pwbsu/Raspberry-Pi-Laparoscope/Documents/Prelimanry Report/chaps-append/chap-drawing.tex

\chapter{Drawings}
\label{sec:Drawings}

\begin{figure}[H]
    \centering
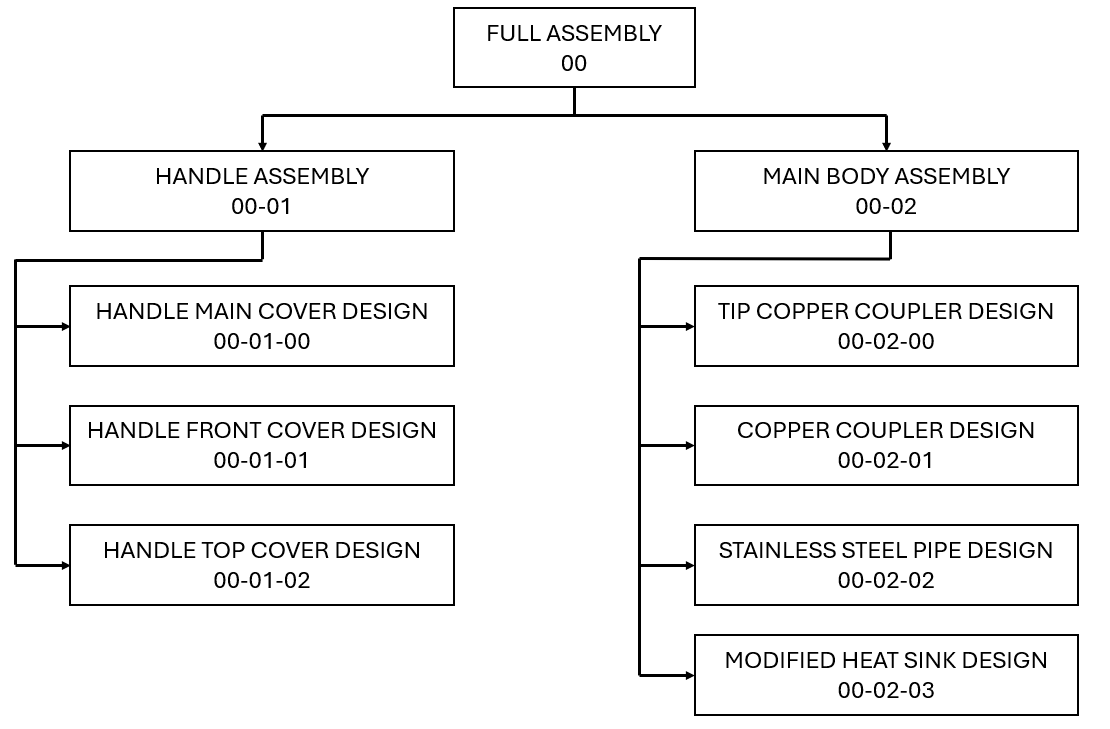
[picture p13: Documents/Prelimanry Report/figs/Drawing Tree.png]
    
    
    \label{fig:ADrawing Tree}
\end{figure}

\begin{landscape}
    \begin{figure}[H]
        \centering
        
        
        \label{fig:App Full Assembly}
    \end{figure}

    \begin{figure}[H]
        \centering
        
        
        \label{fig:App Main Assembly}
    \end{figure}
\end{landscape}
