pwbsu/Raspberry-Pi-Laparoscope/Documents/Prelimanry Report/chaps-main/chap-heat.tex

\chapter{Heat Transfer Evaluation}
\label{sec:Heat}
