pwbsu/Raspberry-Pi-Laparoscope/Documents/Progress Report/chaps-main/chap-conclusion.tex

\chapter{Conclusions}
\label{sec:Conclusion}

\section{Conclusion}

Laparoscopy is a rapidly expanding industry in the medical field. Its an innovative approach to minimize the harm surgeons inflict on the patients. However, it is a more complex procedure to perform, thus requiring more training. Consequently, there is a desire for medical robots to assist surgeons during laparoscopic surgery.

\vspace{0.5cm}
\noindent
Therefore, there is a need for a low-cost laparoscope for training purposes. Consequently, it can be used for prototype testing of new medical robots. This low-cost laparoscope is to be tested to determine its functionality. Therefore, a testing station is required to be developed to determine the laparoscope's capabilities.

\vspace{0.5cm}
\noindent
For this reason, this project aims to develop a low-cost laparoscope in addition to a testing station.
