pwbsu/Raspberry-Pi-Laparoscope/Documents/Design specifications for laparoscope/Diagrams.pptx

Environment

External Environmental Conditions

Legend
Material
Information
Energy

DIP_03, DIP_06

Wider System of Interest

Laparoscope standards

DIP_01, DIP_05, DIP_07

DIP_08

Narrower System of Interest

End-user

Stellenbosch University

Power Storage

DIP_04

DIP__02

## Slide 2

Digital storage unit

Digital storage unit

Legend
Material
Information
Energy

Signal

6.0

Store system data

User input

1.0

User Interface

Signal

2.0

System processor

Signal

AND

Signal

5.0

Display real-time images

Real-time display

Signal

4.0

Signal

Operate camera module

Electrical energy

3.0

Electrical energy

AND

Electrical energy

Power supply

Electrical energy

## Slide 3

4.0 Operate Camera Module

Legend
Material
Information
Energy

4.1

Signal

Configure camera properties

4.3

Signal

AND

Signal

Capture digital image

Signal

Signal

4.2

Configure light intensity

Electrical energy

Electrical energy

## Slide 4

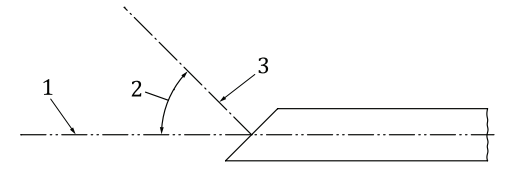
[picture p14: figure]

Camera Axis

Axial Rod Axis

Viewing Angle
