pwbsu/Raspberry-Pi-Laparoscope/Documents/Design specifications for laparoscope/Problem Definition.docx

Problem Definition:

Laparoscopic surgery is a minimally invasive surgery technique, that allows patients to recover faster and experience reduced amounts of post operations pain. However, the main drawback of this procedure is the complexity to perform these operations as well as the steep learning curve to learn the techniques.

Laparoscopic surgical robots are also a new development in the medical industry. There is current product available for commercial surgical use, however, there are new version being developed. Consequently, during testing of the prototypes of new developed robotic system, it isn’t required to use expensive medical grade equipment.

Additionally, Stellenbosch university would like to have a demonstration station during future career days, where participants can use a laparoscope to perform laparoscopic surgery on phantom bodies, to visualize the experience.

For the reasons above, a low-cost laparoscope needs to be developed. The developed product should look and functions as a standard laparoscope. However, since it will not be used on alive patients, the developed product should not meet any medical standards, considering the quality and materials used of the system. The developed should be able to fit inside a Ø 10 mm hole, should exhibit the same functional requirements a standard medically approved laparoscope.
