pwbsu/Raspberry-Pi-Laparoscope/Documents/Detail Design/Diagrams.pptx

Camera and LEDs

Laparoscope encasing

PCB

Heat Pipe
