pwbsu/Raspberry-Pi-Laparoscope/Documents/Safety Reports/Diagrams.pptx

Computer

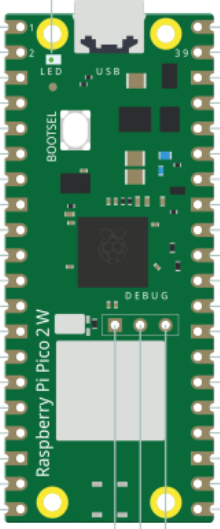
[picture p20: figure]

DS18B20

DS18B20

DS18B20

4,7 kΩ

Legend
Ground
DQ
USB Micro-B

## Slide 2

Computer

5 V

DC Power Supply

Endoscope camera module

DS18B20

100 Ω

4,7 kΩ

100 Ω

100 Ω

100 Ω

Legend
Ground
DQ
USB
