pwbsu/Raspberry-Pi-Laparoscope/Documents/Detail Design/Drawings/Drawing Tree.pptx

FULL ASSEMBLY
00

HANDLE ASSEMBLY
00-01

MAIN BODY ASSEMBLY
00-02

TIP COPPER COUPLER DESIGN
00-02-00

HANDLE MAIN COVER DESIGN
00-01-00

HANDLE FRONT COVER DESIGN
00-01-01

COPPER COUPLER DESIGN
00-02-01

HANDLE TOP COVER DESIGN
00-01-02

STAINLESS STEEL PIPE DESIGN
00-02-02

MODIFIED HEAT SINK DESIGN
00-02-03
