pwbsu/Raspberry-Pi-Laparoscope/Documents/Detail Design/Drawings/Drawing_Pack.docx

# Laparoscope Drawing Pack

| Student | Supervisor
Initials and Surname | PW Breytenbach | Prof K. Schreve
Email Address | 26122146@sun.ac.za | kschreve@sun.ac.za
Contact Number | 078 780 9388
Signature

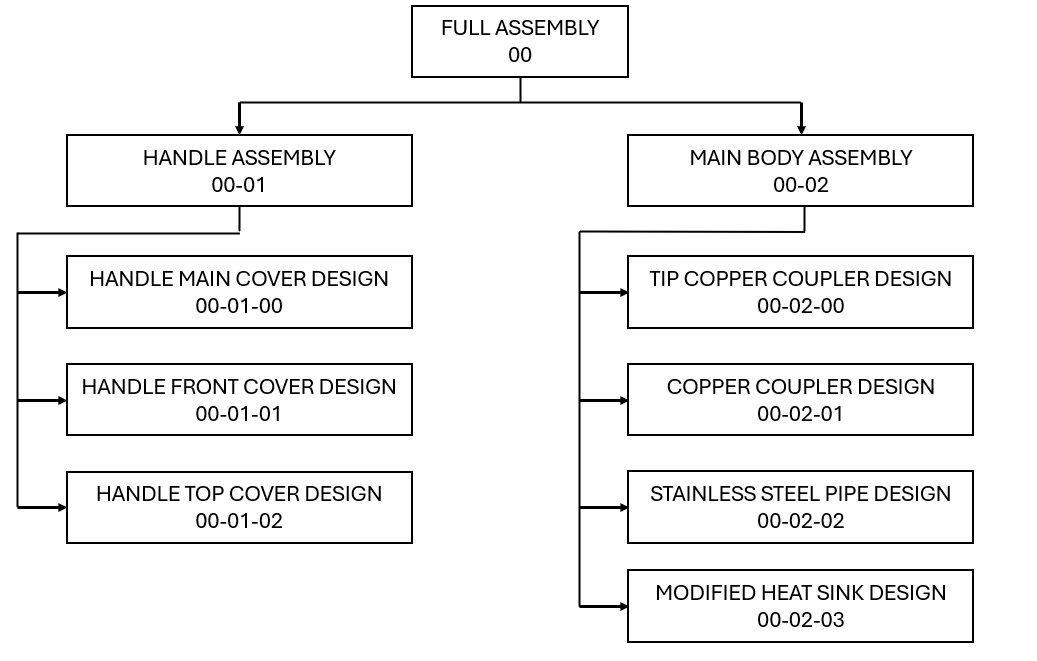
[picture p21: figure]

Notes for the assembly:

Parts that interface with each other that are not connected by a bolt and nut connection are secured by epoxy. Thus, all parts that interface with the heat pipes and stainless steel pipe will be secured by epoxy. The entire assembly of the design will be performed by the student, including the application of epoxy.

Order of assembling the handle of the laparoscope:

1. Assemble the entire main body assembly, except for the heat sinks.
2. Insert and secure the heat pipe and stainless steel pipe into the “Handle Front Cover”.
3. Connect the heat pipe to the heat sinks.
4. Connect the “Handle Front Cover” to the “Handle Main Cover”.
5. Connect the heat sinks to the “Handle Main Cover”.
6. Connect the “Handle Top Covers” to the “Handle Main Cover”.

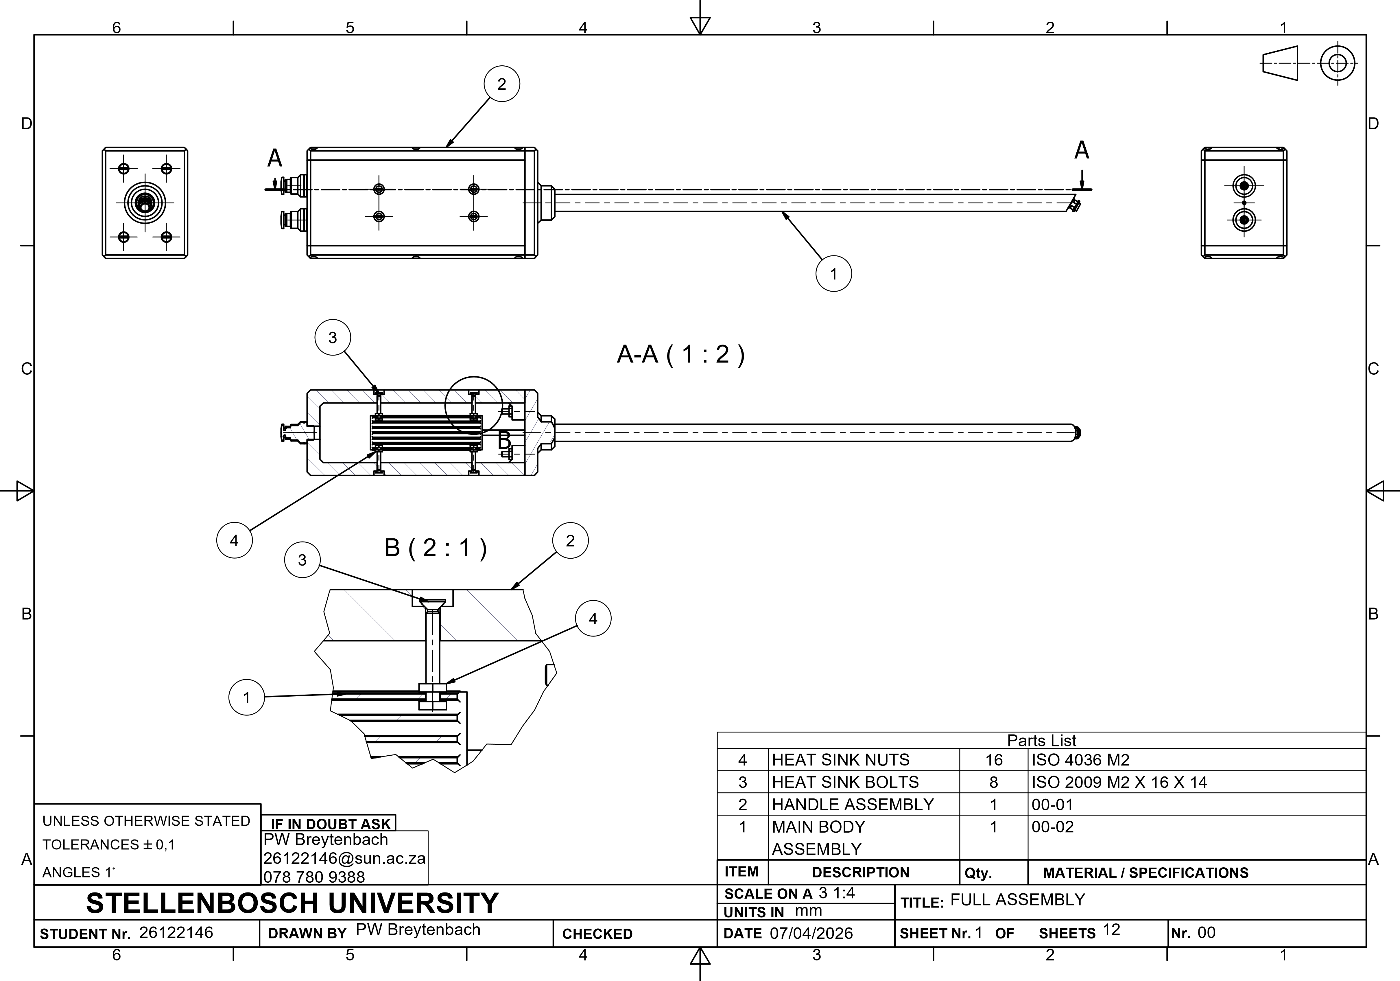
[picture p22: figure]
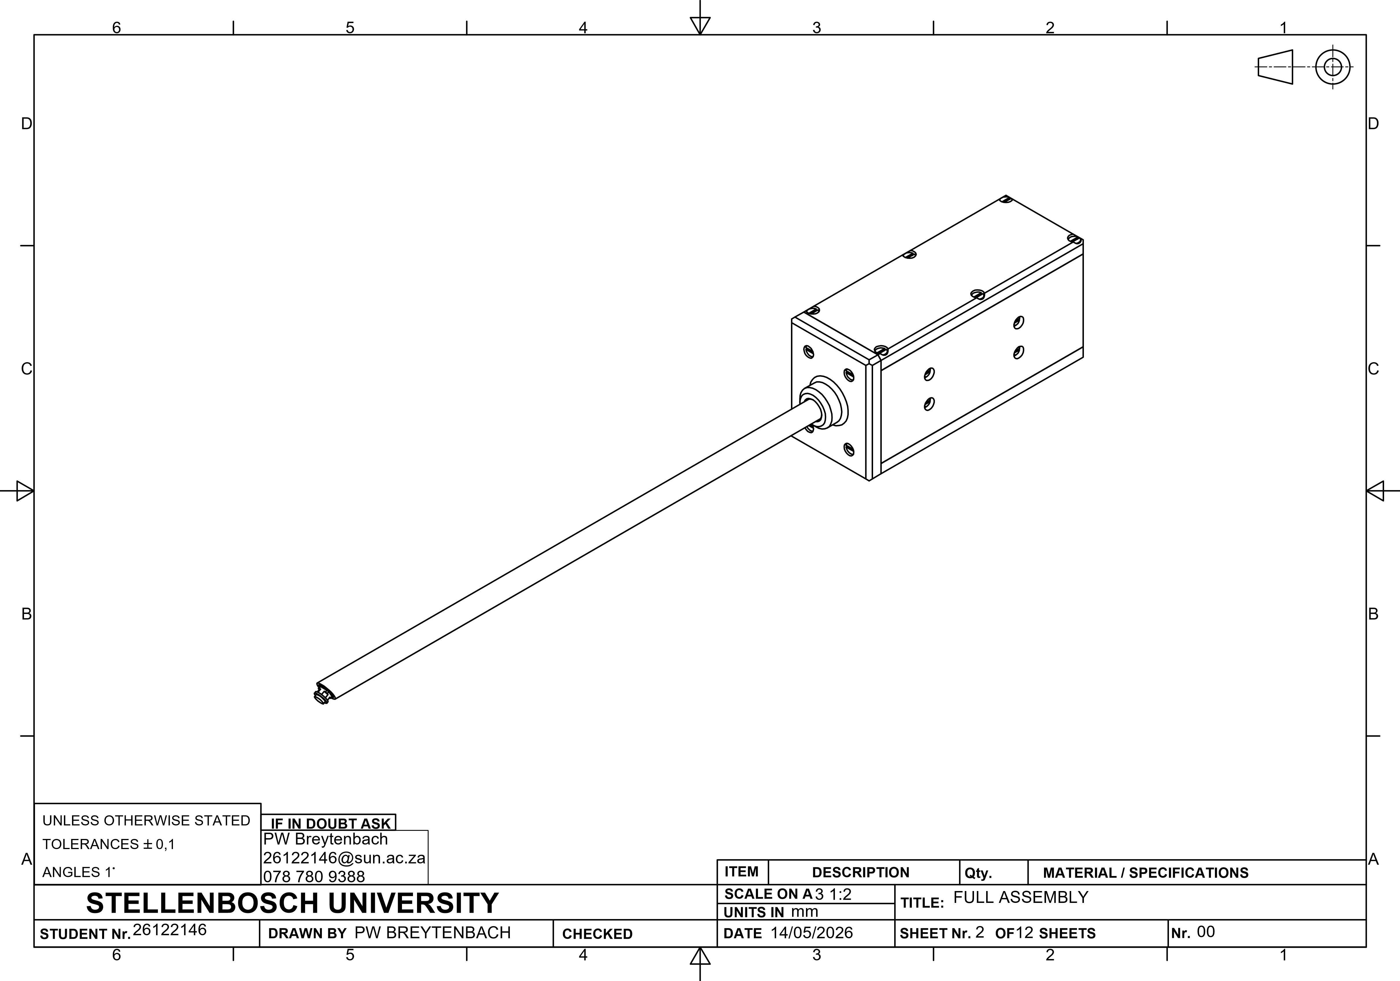
[picture p23: figure]
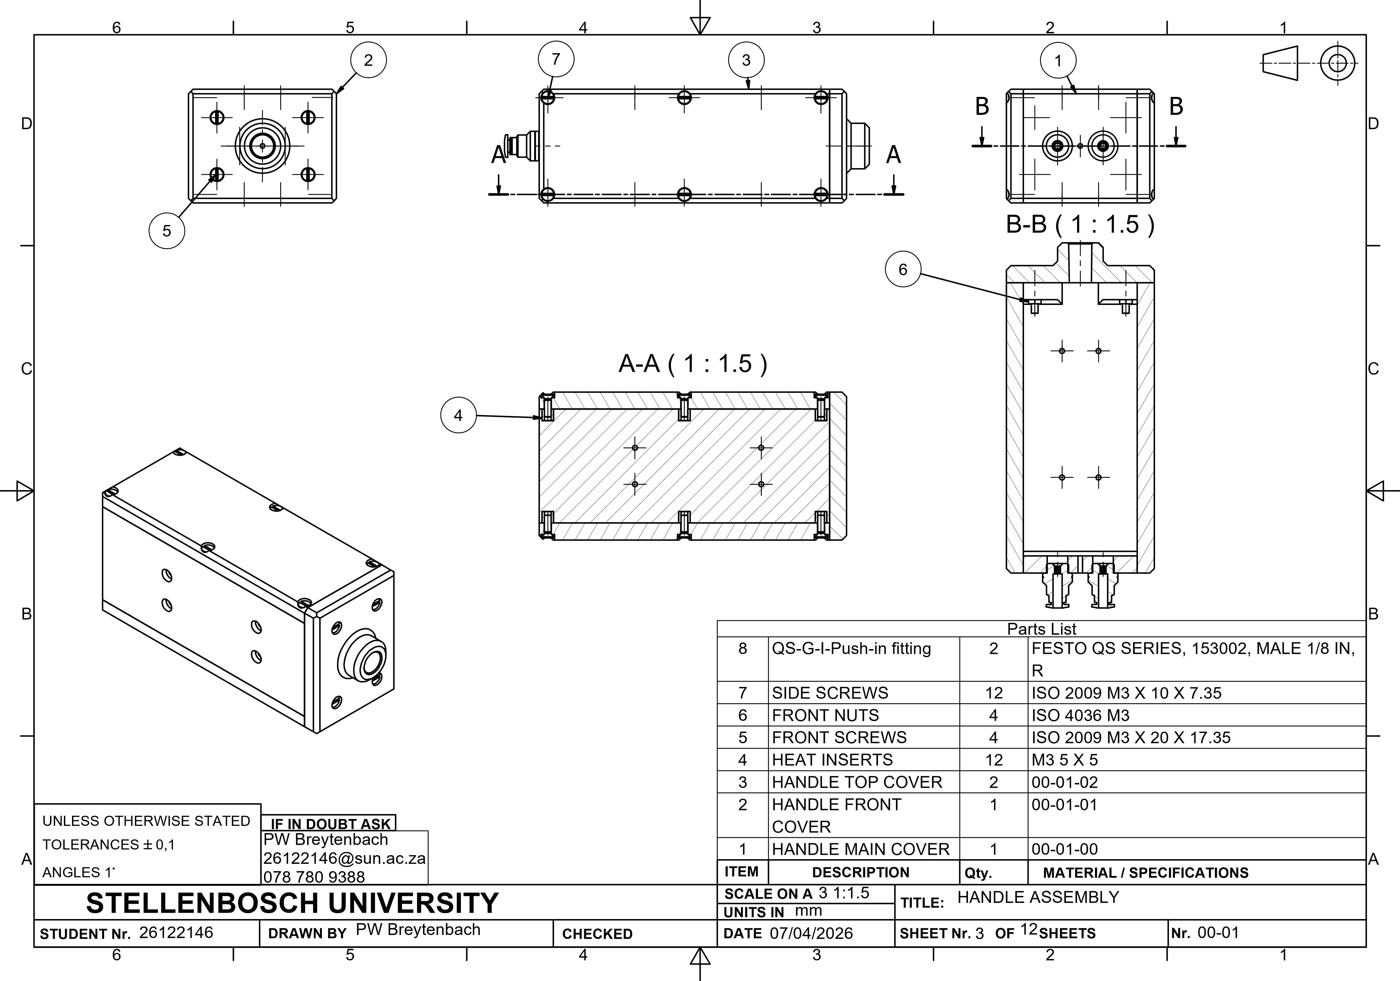
[picture p24: figure]
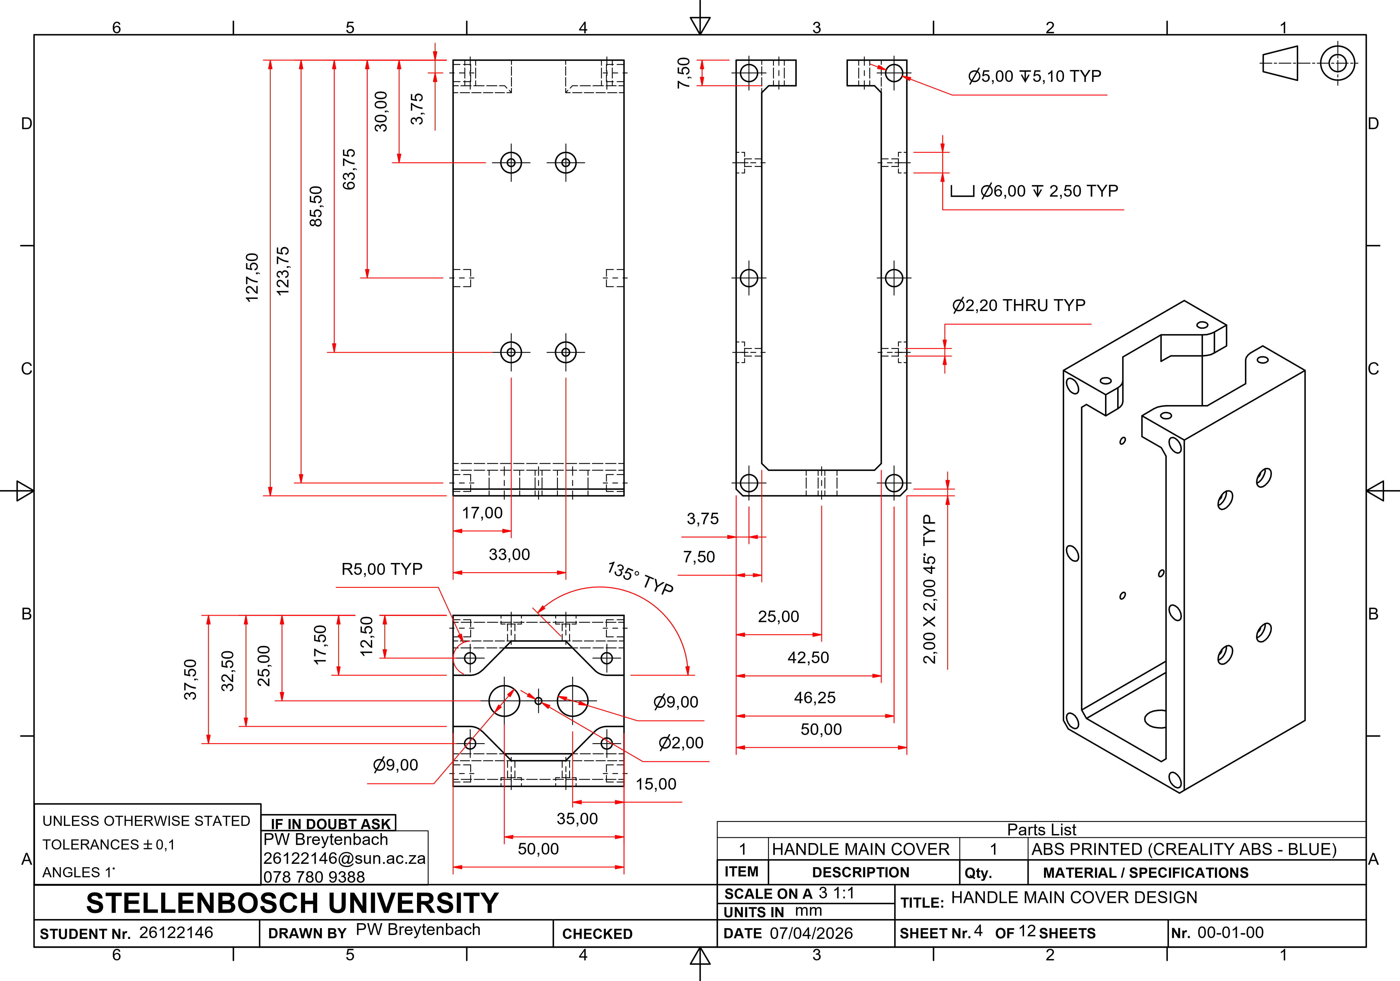
[picture p25: figure]
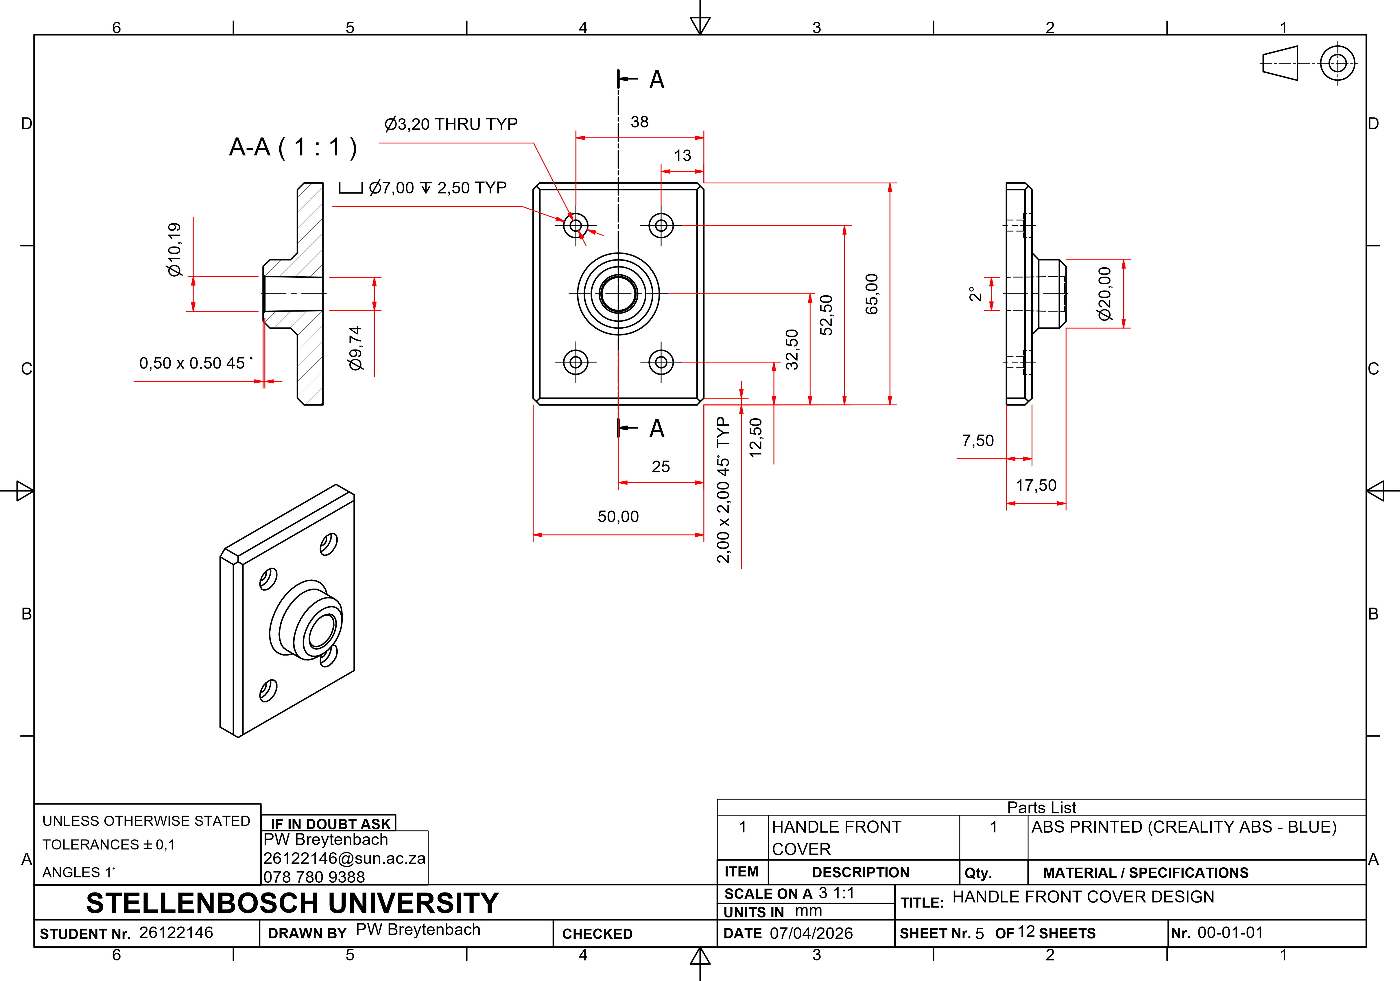
[picture p26: figure]
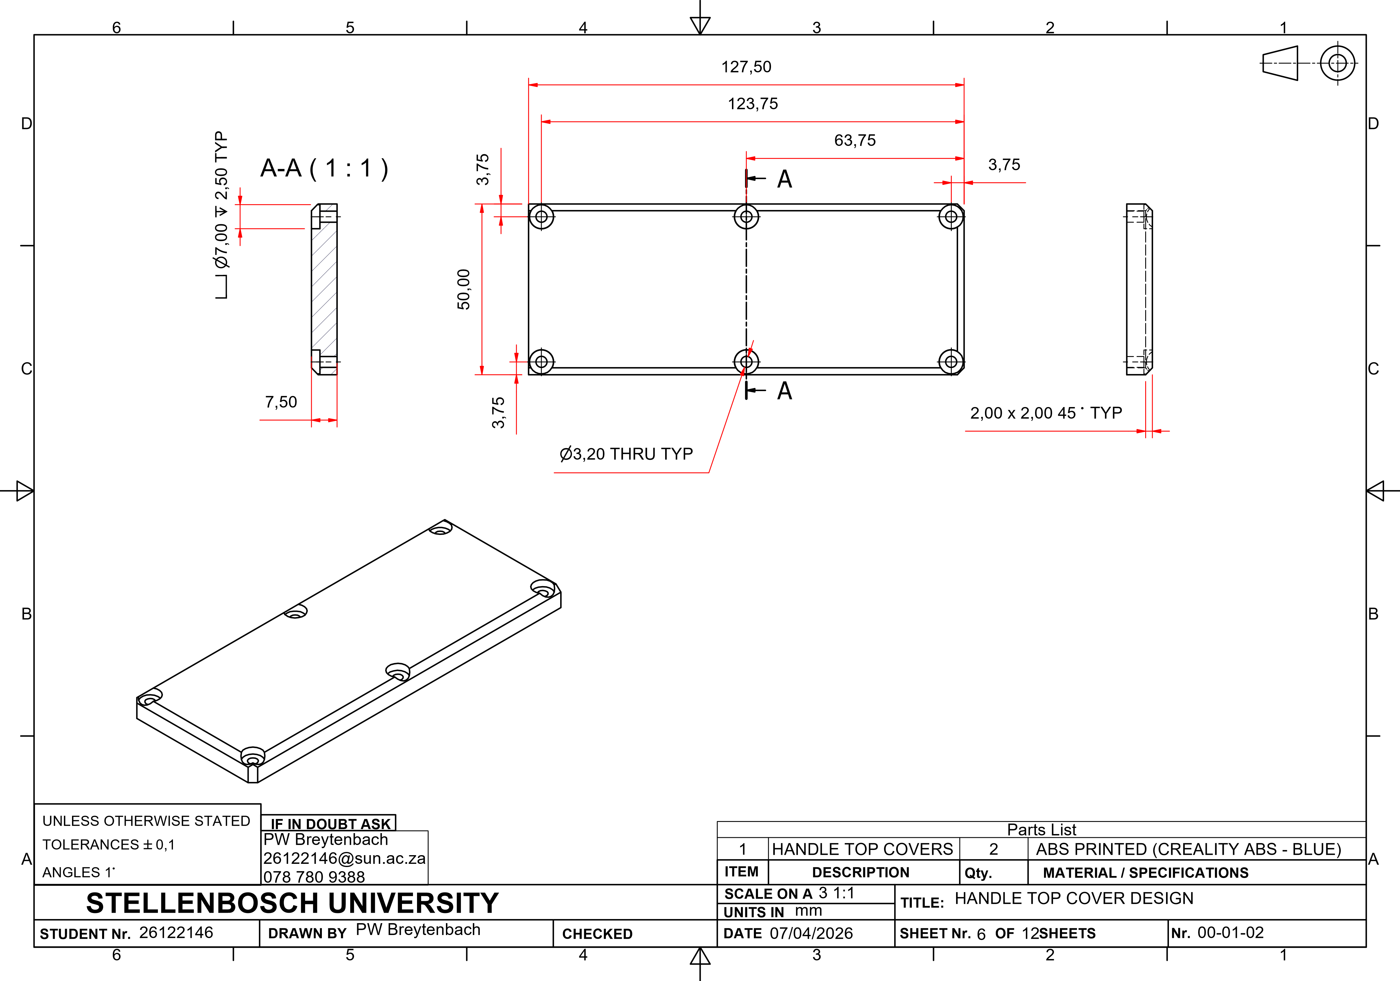
[picture p27: figure]
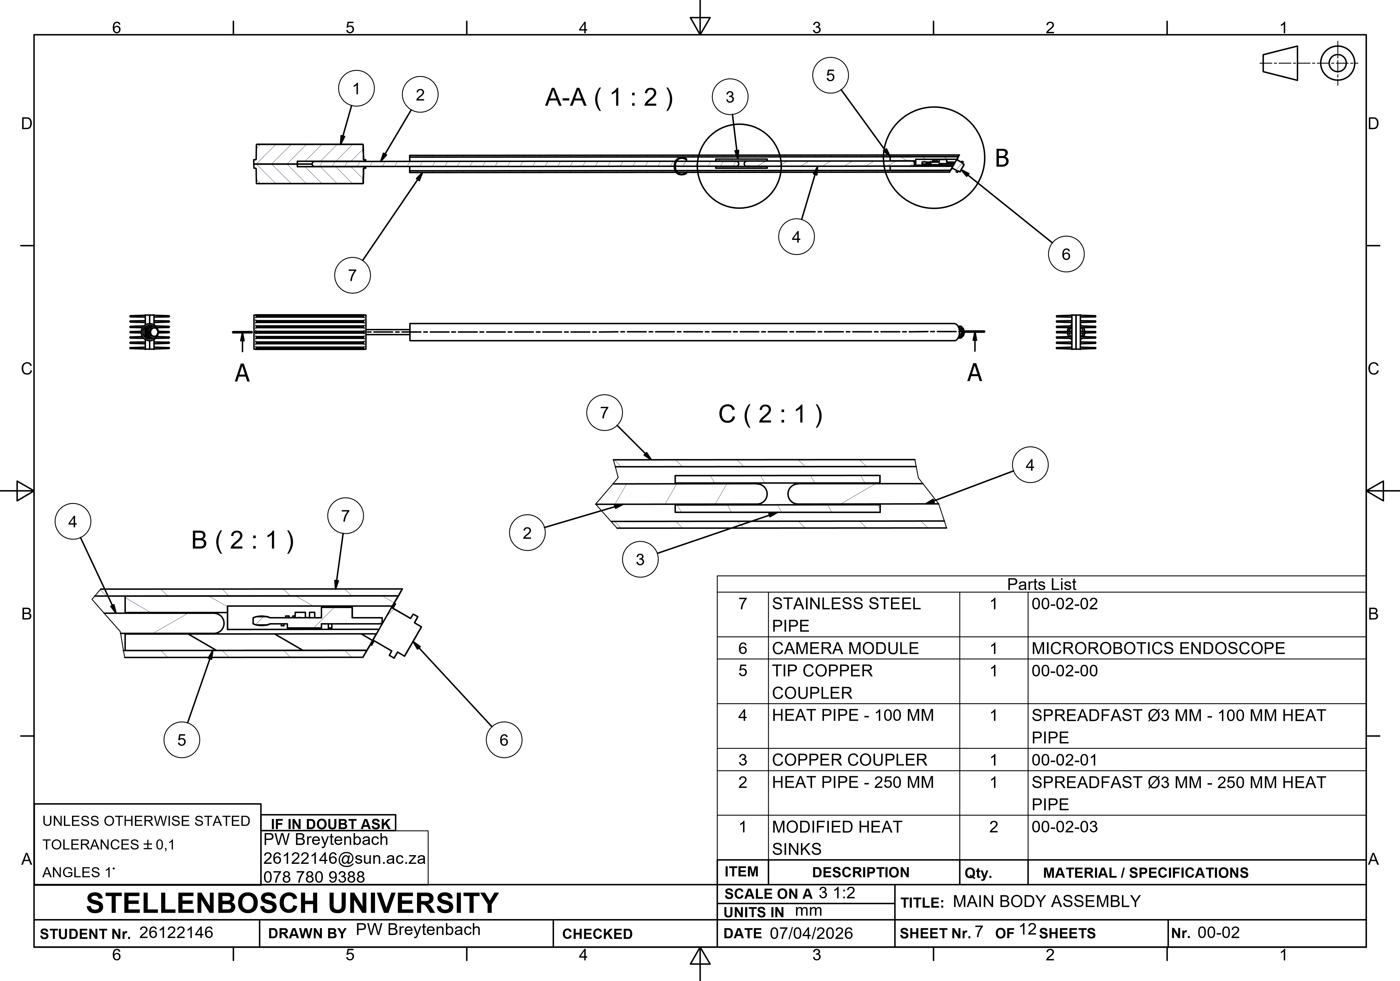
[picture p28: figure]
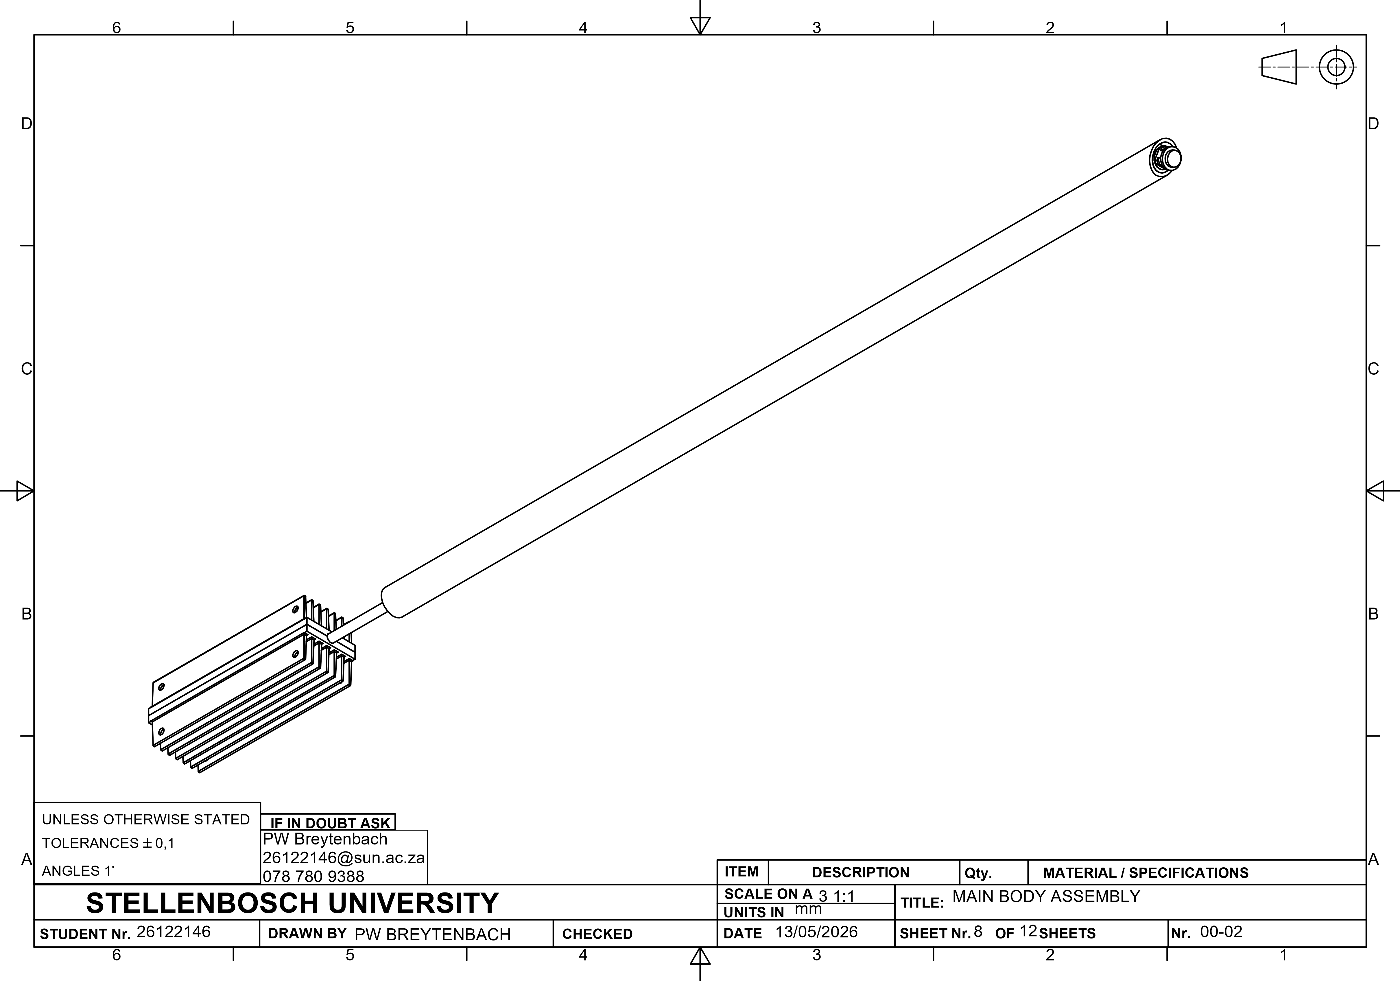
[picture p29: figure]
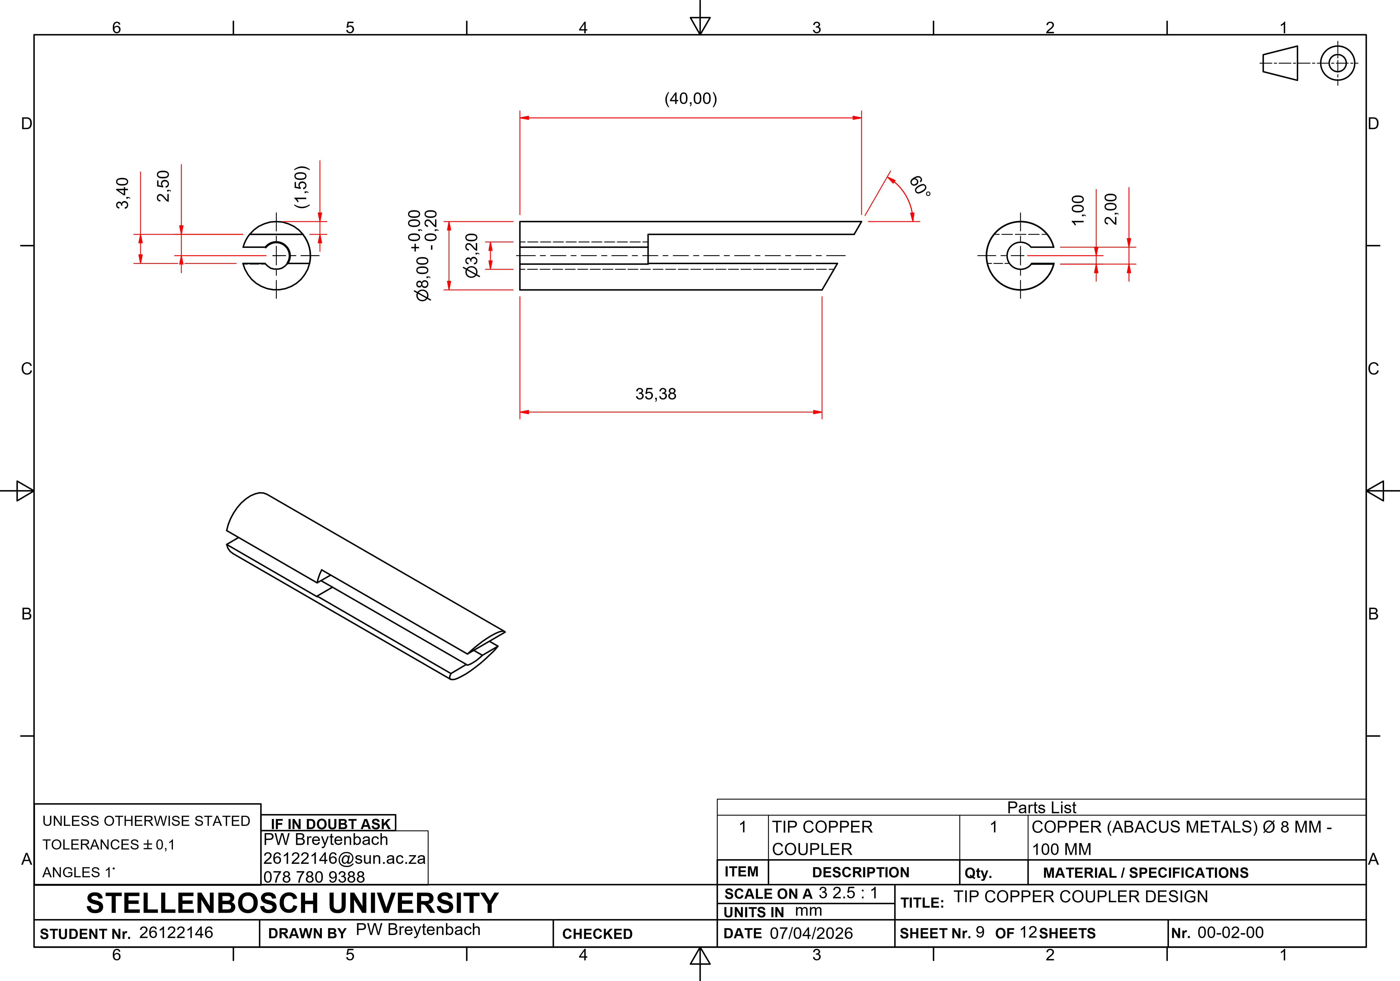
[picture p30: figure]
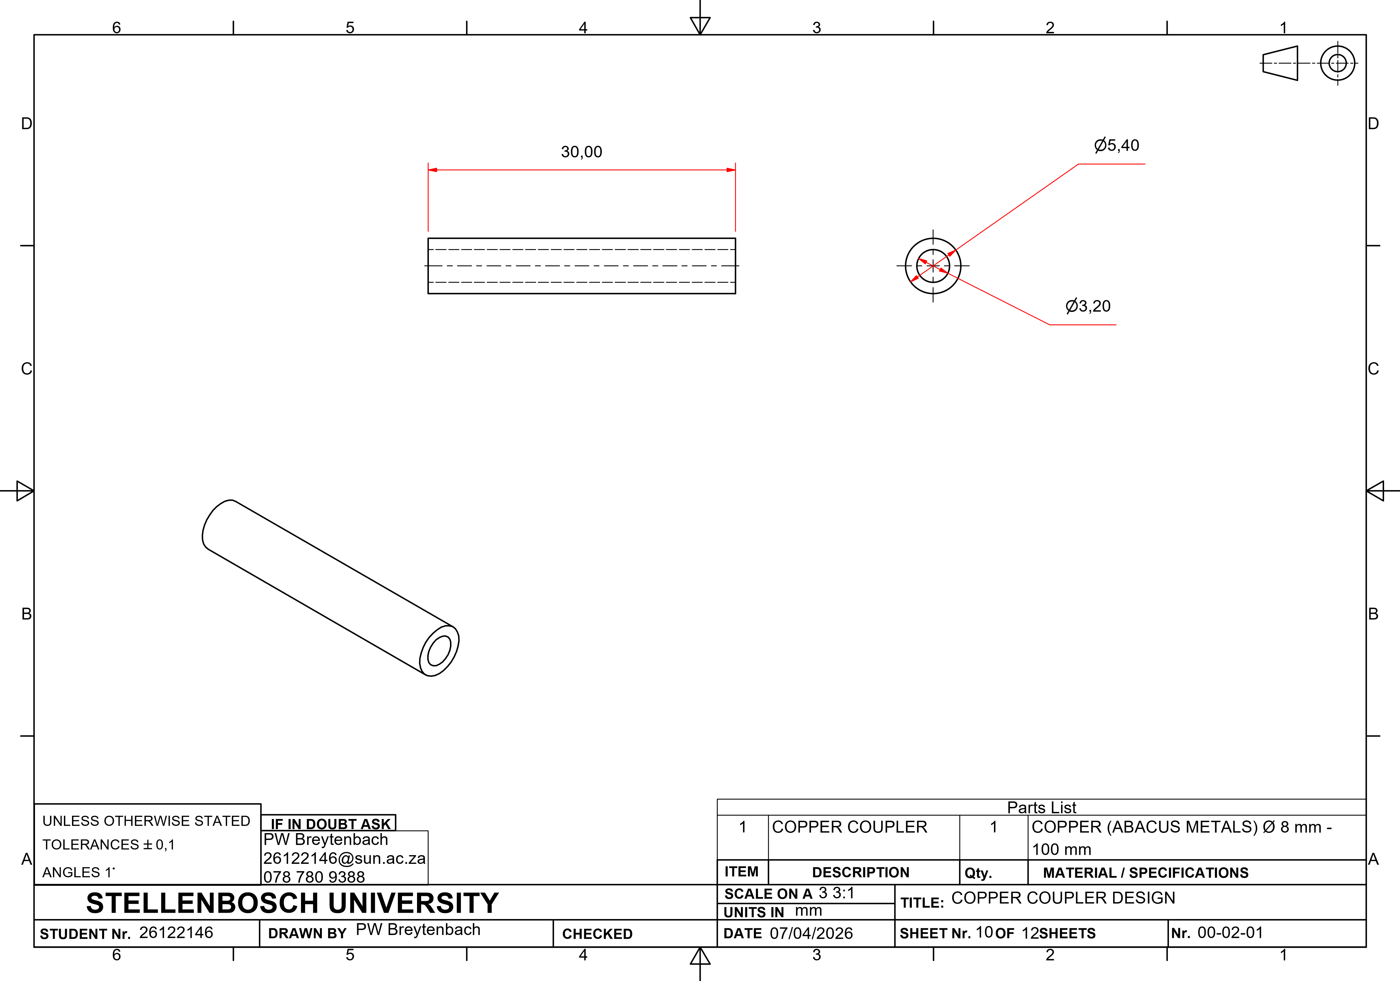
[picture p31: figure]
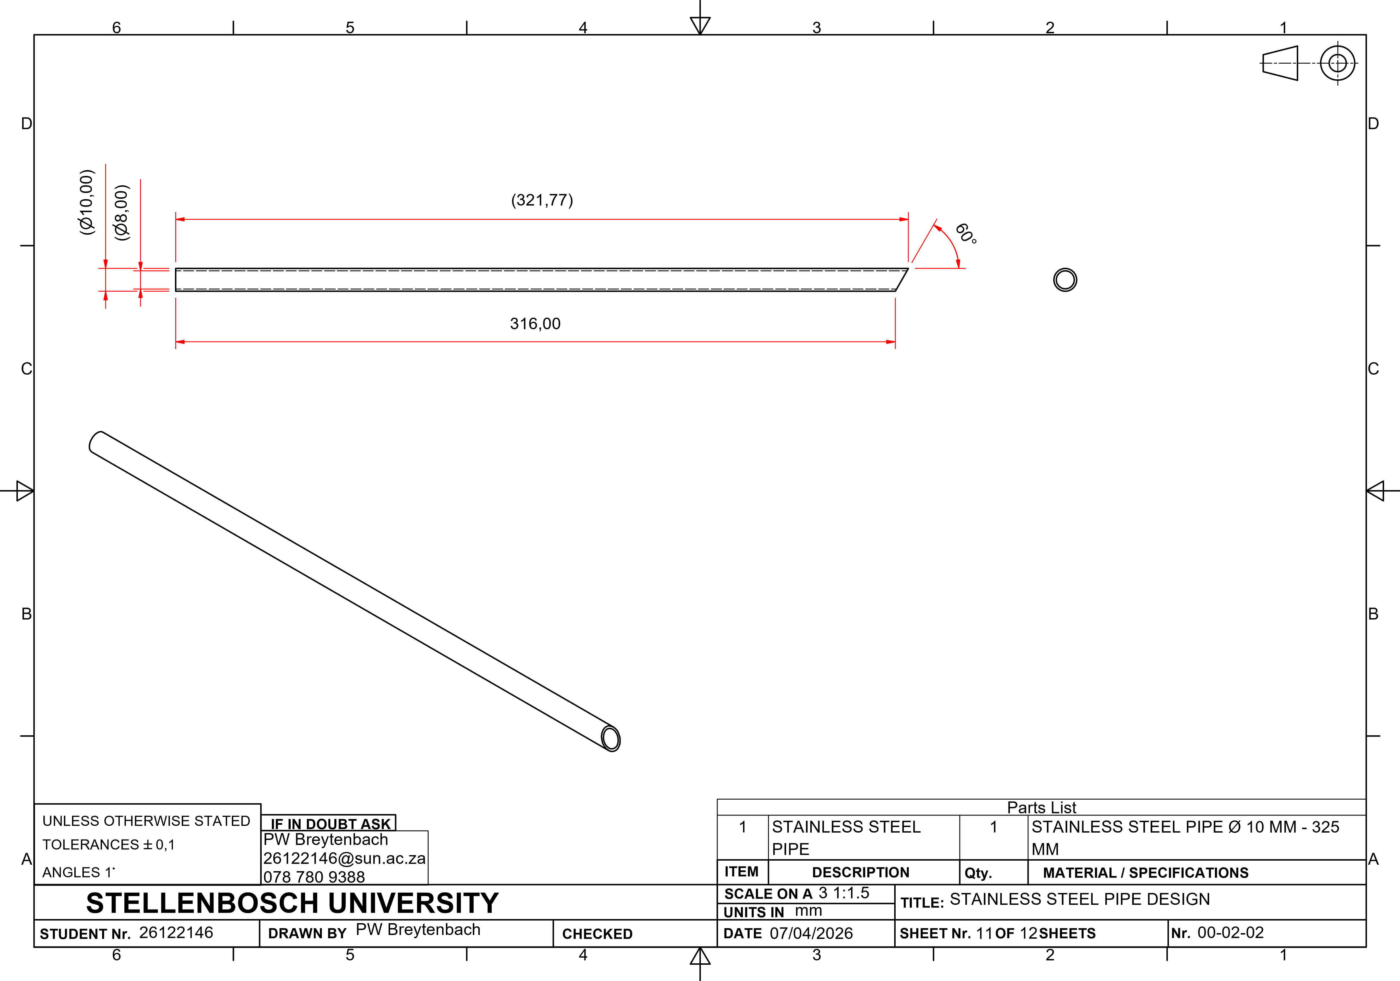
[picture p32: figure]
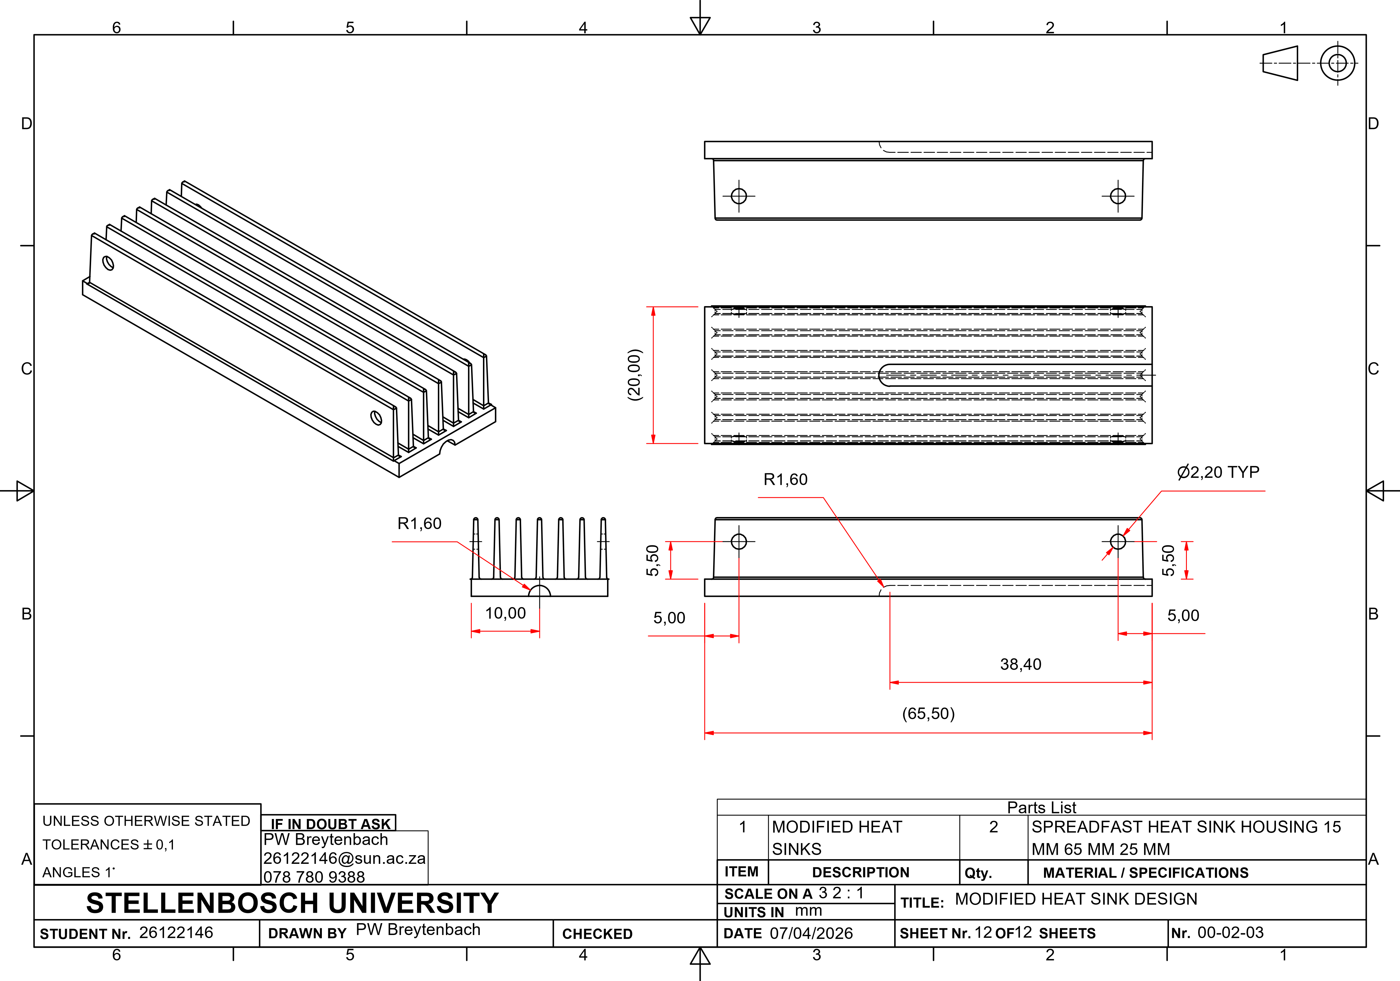
[picture p33: figure]
