pwbsu/Raspberry-Pi-Laparoscope/Admin/Meetings/17 Feb 2026/Background, Aim and objectives.docx

# Background:

The Hippocratic Oath is a fundamental principle that guides decisions and advancements in the medical profession. It motivates doctors and physicians to make ethical decisions to minimize patient harm. It also drives physicians to continuously improve practices to reduce surgical risks and complications. This principle has driven the discovery of minimally invasive surgery (MIS). (Alkatout, et al., 2021)

Minimally invasive surgery has become the standard practice across surgical fields and is a rapidly growing division in the medical industry. One branch of this field is laparoscopy, which is used to perform advanced and complex surgical procedures.

Laparoscopy is surgical approach where small incisions are made to allow insertion of specialized equipment into the patient’s body. The primary instrument is the laparoscope, which is typically paired with other thin rod equipment based on the operations demands. (Subido, Pacis, & Bugtai, 2018) Compared to traditional open surgery, laparoscopy offers advantages including faster recovery rates and reduced morbidity and patient discomfort, though it requires a steeper learning curve. These benefits translate to cost savings through shorter hospital stays and reduced analgesic requirements (Buia, Stockhausen, & Hanisch, 2015)

The laparoscope is a fundamental instrument to laparoscopic surgery. It consists of a thin rod with an attached camera that is inserted into the patient’s body. The captured footage is displayed in real-time to the surgical staff on a monitor. Based on the visible footage, the surgical staff make diagnosis, perform procedures, and coordinate instrument positioning based on the visual feedback.

Recent advancements in laparoscopy focus on improving the laparoscope’s visual capabilities through several approaches. These approaches include increasing the camera’s field of view, implementing three-dimensional (3D) visualization, and incorporating artificial intelligence (AI) or machine vision technologies to captured footage. Additional advancement made to modern laparoscopes is the utilization of robotic manipulators, with 3 or more degrees of freedom (DOF) to assist the doctor during operations. (Subido, Pacis, & Bugtai, 2018)

One of the main challenges of laparoscopic surgery is that it is a technically complex surgery to perform. Thus, more training is required by inexperienced surgeons. However, laparoscopes are expensive equipment which makes them inaccessible to individual practitioners or small hospitals to purchase. (Xiao, et al., 2014)

Therefore, there is a need of a low-cost laparoscope.

# Aim and Objectives

The aim of this project is to design, build, and test a low-cost laparoscope.

This project’s main objectives are to:

- Design, build and program a functional laparoscope by incorporating various Raspberry Pi components.
- Design a performance test to assess the laparoscope functionality and image quality abilities.
- Evaluate the developed laparoscope against established industry standards.

# Use of AI Tools

Anthropic is the main Artificial Intelligence (AI) company that will be used for this project, specifically its Claude Sonnet 4.5 model. This AI model assisted with research papers identification, sentence construction, grammar checks and code debugging. All AI-generated material will be reviewed and verified by the student to ensure the integrity and originality of the provided work.
