pwbsu/Raspberry-Pi-Laparoscope/Documents/Detail Design/Micro Robotics Camera Module/Images of Camera.docx

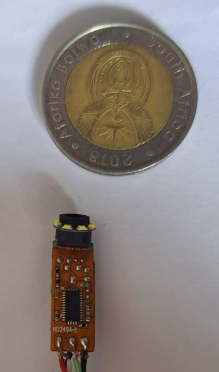
[picture p66: figure]
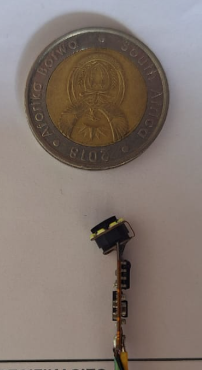
[picture p67: figure]
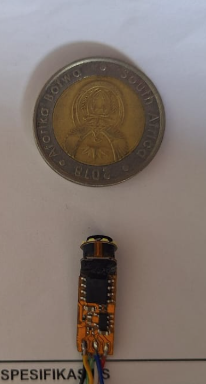
[picture p68: figure]
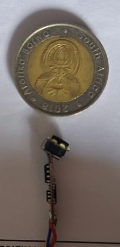
[picture p69: figure]
