pwbsu/Raspberry-Pi-Laparoscope/Documents/Prelimanry Report/gantt_chart.pdf

Skripsie | 01 Mar 2026
Stellenbosch University,
Engineering Facaulty,

## Mechanical and Mechatronic Department

| http://

Project manager
Project dates | 03 Mar 2026 - 16 Jun 2026
Completion | 0%
Tasks | 94
Resources | 0

This gannt chart will show the schedule for the skripise topic: Raspberry Pi Laparoscope.

Student number: 26122146
Student initails and surname: PW Breytenbach

Name | Be gi n
| da te

End date

Literature Review | 20 26/ 03/
| 03

2026/03/05

Review Previous Literature | 20 26/ 03/
| 03

2026/03/03

Review Current Laparoscope Specifiations | 20 26/ 03/
| 04

2026/03/04

Review Testing Laparoscope Specifications | 20 26/ 03/
| 05

2026/03/05

Component Review | 20 26/ 03/
| 06

2026/03/11

Review Camera modules | 20 26/ 03/
| 06

2026/03/07

Review Single Board Computers | 20 26/ 03/
| 09

2026/03/09

Review Illumination Modules | 20 26/ 03/
| 10

2026/03/10

Review Monitor Module | 20 26/ 03/
| 10

2026/03/10

Review Software interfaces | 20 26/ 03/
| 11

2026/03/11

Compile Design Requirements for Laparoscope | 20 26/ 03/
| 06

2026/03/11

Problem Defintion | 20 26/ 03/

2026/03/06

Skripsie | 01 Mar 2026

## Tasks

Name | Be gi n
| da te

End date

Determine Stakeholder Requirements | 20 26/ 03/
| 07

2026/03/07

Determine Design Independent Parameters | 20 26/ 03/
| 07

2026/03/07

Determine Boundary of the System | 20 26/ 03/
| 09

2026/03/09

Determine Functional Requirements | 20 26/ 03/
| 10

2026/03/10

Determine Non-functional Requirements | 20 26/ 03/
| 10

2026/03/10

Determine the Technical Performance Measures | 20 26/ 03/
| 11

2026/03/11

Generate Concept Design of Laparoscope | 20 26/ 03/
| 12

2026/03/19

Generate the First Concept | 20 26/ 03/
| 12

2026/03/12

Generate the Second Concept | 20 26/ 03/
| 13

2026/03/13

Generate the Third Concept | 20 26/ 03/
| 14

2026/03/16

Evaluate the Concepts | 20 26/ 03/
| 17

2026/03/17

Select the Best Concept | 20 26/ 03/

2026/03/18

Name | Be gi n da te

End date

Refine Selected Concept | 20 26/ 03/
| 19

2026/03/19

Finalise Detail Design for Laproscope | 20 26/ 03/
| 20

2026/03/28

Perform Analysis of Concept | 20 26/ 03/
| 20

2026/03/21

Perform Detail Design | 20 26/ 03/
| 23

2026/03/25

Perform Final Analysis of Detail Design | 20 26/ 03/
| 26

2026/03/26

Produce Drawing Pack | 20 26/ 03/
| 27

2026/03/28

Compile Design Requirements for the Test Station | 20 26/ 04/
| 01

2026/04/03

Problem Definition | 20 26/ 04/
| 01

2026/04/01

Determine Stakeholders | 20 26/ 04/
| 01

2026/04/01

Determine Independent Design Parameters | 20 26/ 04/
| 01

2026/04/01

Determine Boundary of the System | 20 26/ 04/
| 02

2026/04/02

Determine Functional Requirements | 20 26/ 04/

2026/04/02

Tasks | 4

Name | Be gi n
| da te

End date

Determine Non-Funcitonal Requirements | 20 26/ 04/
| 02

2026/04/02

Determine Technical Performance Measures | 20 26/ 04/
| 03

2026/04/03

Generate Concept Design for Test Station | 20 26/ 04/
| 04

2026/04/10

Generate the First Test Concept | 20 26/ 04/
| 04

2026/04/04

Generate the Second Test Concept | 20 26/ 04/
| 06

2026/04/06

Generate the Third Test Concept | 20 26/ 04/
| 07

2026/04/07

Generate the Fourth Test Concept | 20 26/ 04/
| 08

2026/04/08

Evaluate Test Concepts | 20 26/ 04/
| 09

2026/04/09

Select and Eliminate Test Concepts | 20 26/ 04/
| 09

2026/04/09

Refine Selected Test Conepts | 20 26/ 04/
| 10

2026/04/10

Finalise Detail Design for Test Station | 20 26/ 04/
| 11

2026/04/20

Perform Analysis of Test Station Concept | 20 26/ 04/

2026/04/11

Name | Be gi n
| da te

End date

Perform Detail Design | 20 26/ 04/
| 13

2026/04/14

Perform Analysis on the Detail Design | 20 26/ 04/
| 15

2026/04/15

Produce Drawing Pack | 20 26/ 04/
| 16

2026/04/17

Articulate the Test Procedures | 20 26/ 04/
| 18

2026/04/20

Construct and Implement Laparoscope | 20 26/ 03/
| 20

2026/05/01

Learn Programming Langauge | 20 26/ 03/
| 20

2026/04/20

Implement Camera Module | 20 26/ 04/
| 21

2026/04/23

Implement Montior Display | 20 26/ 04/
| 24

2026/04/25

Implement SBC Functionality | 20 26/ 04/
| 27

2026/04/28

Build the Laparoscope | 20 26/ 04/
| 29

2026/05/01

Construct Test Station | 20 26/ 05/
| 02

2026/05/05

Build Main Test Body | 20 26/ 05/

2026/05/04

Name | Be gi n
| da te

End date

Build Various Test Procedures | 20 26/ 05/
| 05

2026/05/05

Perform Functionality Test | 20 26/ 05/
| 06

2026/05/08

Perform Functionality Test 1 | 20 26/ 05/
| 06

2026/05/06

Perform Functionality Test 2 | 20 26/ 05/
| 07

2026/05/07

Perform Functionality Test 3 | 20 26/ 05/
| 08

2026/05/08

Evaluate Laparoscope | 20 26/ 05/
| 09

2026/05/14

Evalaute the Performance of the Laparoscope | 20 26/ 05/
| 09

2026/05/11

Evalaute the General Laparoscope | 20 26/ 05/
| 12

2026/05/12

Evaluate the Test Station | 20 26/ 05/
| 12

2026/05/13

Document an Improvement Plan | 20 26/ 05/
| 14

2026/05/14

Documentation | 20 26/ 03/
| 04

2026/06/15

Name | Be gi n da te

End date

Document the Literature Review | 20 26/ 03/
| 04

2026/03/06

Document the Design Specification Report for the Laparoscope | 20 26/ 03/
| 07

2026/03/12

Document the Concept Generation Report | 20 26/ 03/
| 13

2026/03/20

Document the Detail Design Report for Laparoscope | 20 26/ 03/
| 23

2026/03/28

Document the Design Specification Report for the Test Station | 20 26/ 04/
| 02

2026/04/04

Document the Concept Generation Report for Test Station | 20 26/ 04/
| 06

2026/04/09

Document Progress Report | 20 26/ 03/
| 04

2026/04/11

Document the Detail Design Report for the Test Station | 20 26/ 04/
| 13

2026/04/20

Docement Safety Report | 20 26/ 03/
| 30

2026/04/13

Document the Building Process | 20 26/ 04/
| 21

2026/05/05

Document the Testing Procedures | 20 26/ 05/
| 07

2026/05/09

Document the Evalaution | 20 26/ 05/
| 12

2026/05/15

Tasks | 8

Name | Be gi n
| da te

End date

Document Final Preliminary Report | 20 26/ 04/
| 13

2026/05/30

Edit Final Preliminary Report | 20 26/ 06/
| 01

2026/06/04

Edit Final Report | 20 26/ 06/
| 05

2026/06/15

Milestones | 20 26/ 03/
| 04

2026/06/15

Proposal Hand-in | 20 26/ 03/
| 04

2026/03/04

Laparoscope Drawing Pack Hand-in | 20 26/ 03/
| 30

2026/03/30

Progress Report Hand-in | 20 26/ 04/
| 13

2026/04/13

Test Station Drawing Pack Hand-in | 20 26/ 04/
| 21

2026/04/21

Safety Report Hand-in | 20 26/ 04/
| 14

2026/04/14

Final Preliminary Report Hand-in | 20 26/ 06/
| 05

2026/06/05

Final Report Hand-in | 20 26/ 06/
| 16

2026/06/16

Gantt Chart | 10

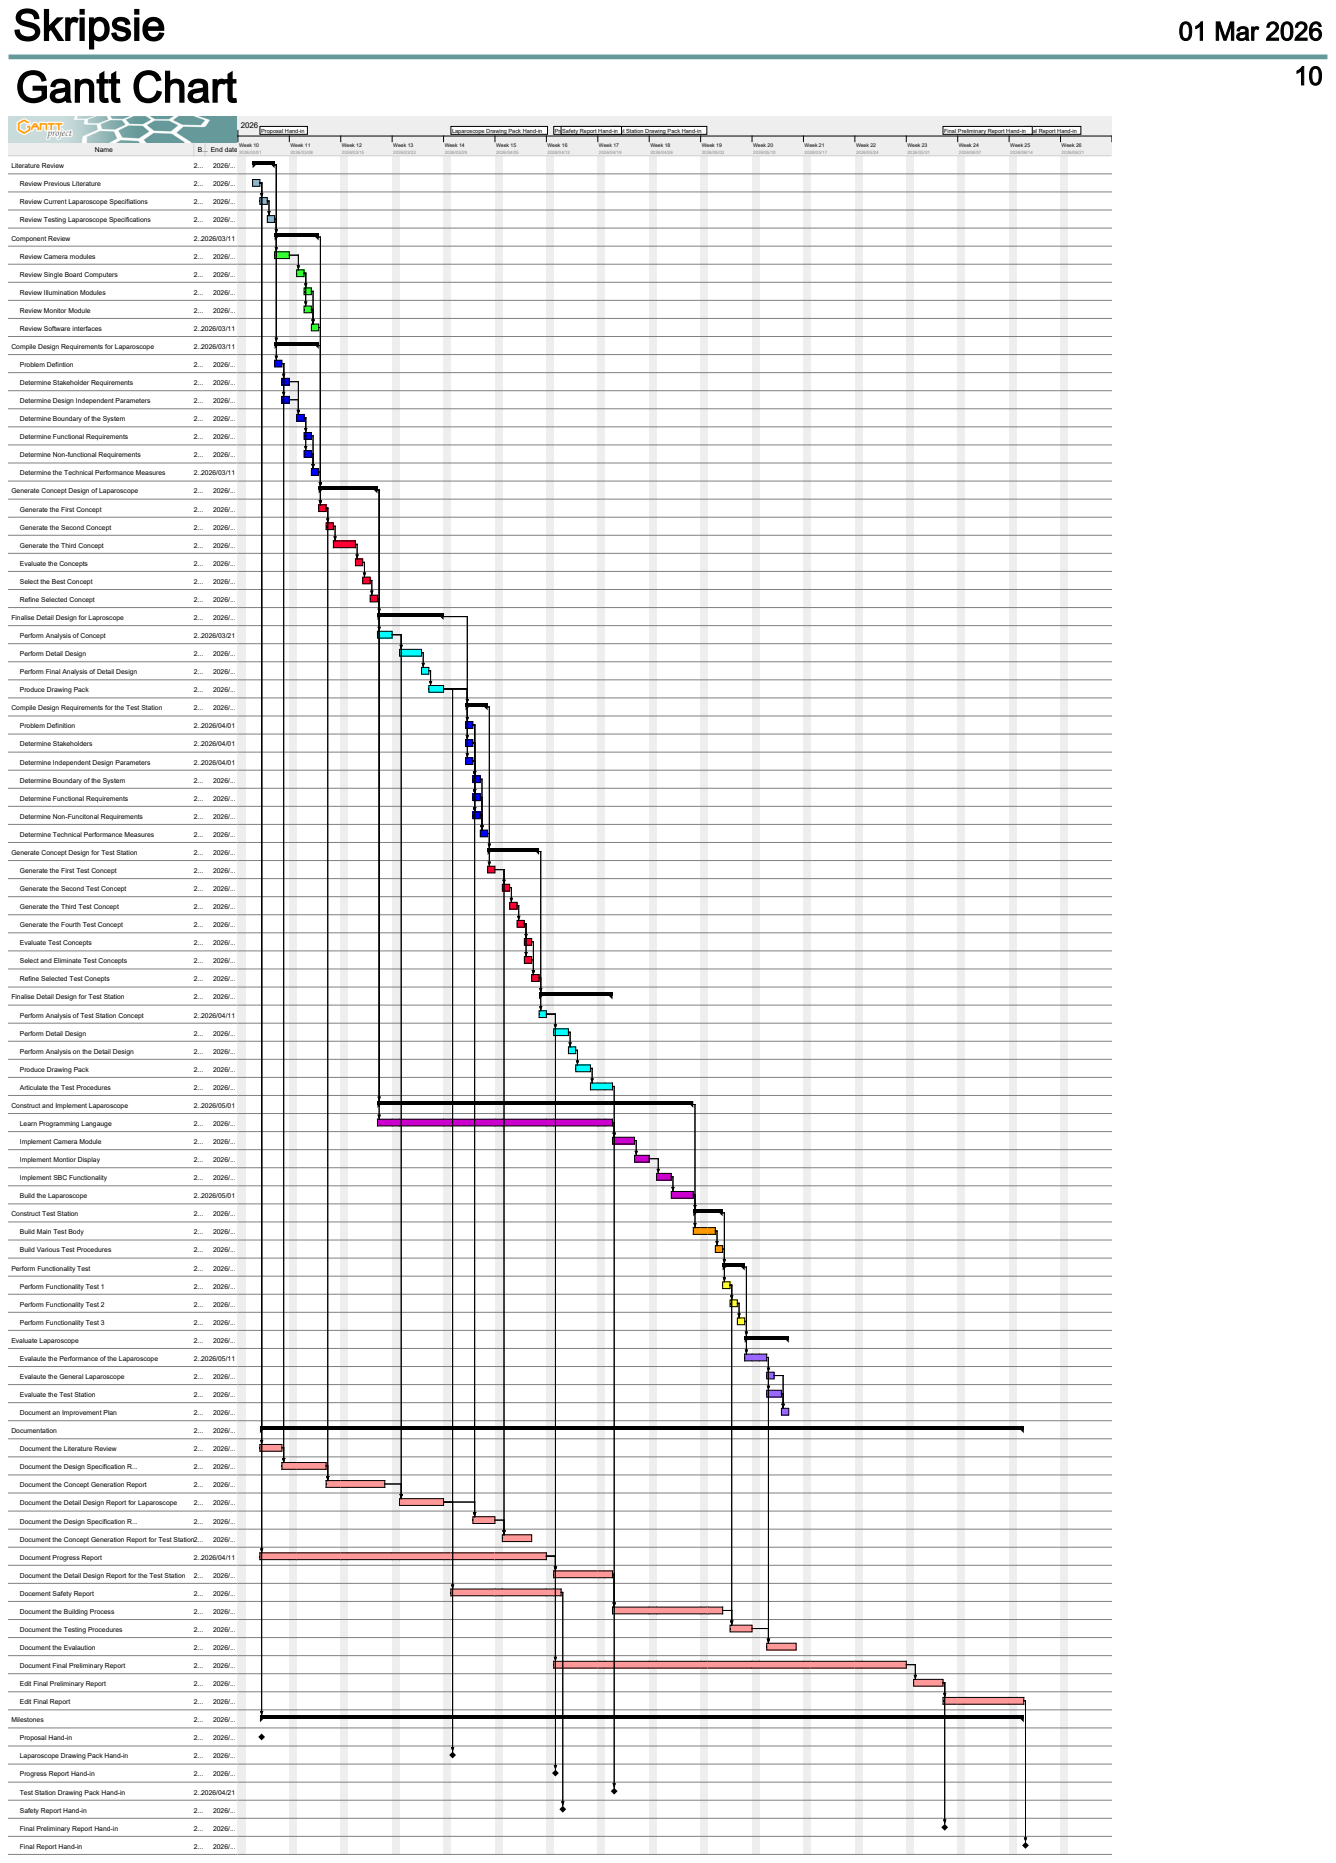
[picture p70: page 10]
Name; End date; Literature Review; Review Previous Literature; Review Current Laparoscope Specifiations; Review Testing Laparoscope Specifications; Component Review; Review Camera modules; Review Single Board Computers; Review Illumination Modules; Review Monitor Module; Review Software interfaces; Compile Design Requirements for Laparoscope; Problem Defintion; Determine Stakeholder Requirements; Determine Design Independent Parameters; Determine Boundary of the System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

Resources Chart | 11
Name | Default role

2026

Week 10 | Week 11 | Week 12 | Week 13 | Week 14 | Week 15 | Week 16 | Week 17 | Week 18 | Week 19 | Week 20 | Week 21 | Week 22 | Week 23 | Week 24 | Week 25 | Week 26
2026/03/01 | 2026/03/08 | 2026/03/15 | 2026/03/22 | 2026/03/29 | 2026/04/05 | 2026/04/12 | 2026/04/19 | 2026/04/26 | 2026/05/03 | 2026/05/10 | 2026/05/17 | 2026/05/24 | 2026/05/31 | 2026/06/07 | 2026/06/14 | 2026/06/21
Proposal Hand-in | Laparoscope Drawing Pack Hand-in | Progress Report Hand-in Safety Report Hand-inTest Station Drawing Pack Hand-in | Final Preliminary Report Hand-inFinal Report Hand-in
