pwbsu/Raspberry-Pi-Laparoscope/Admin/Hand-in/Proposal/Skripsie Gannt Chart.png

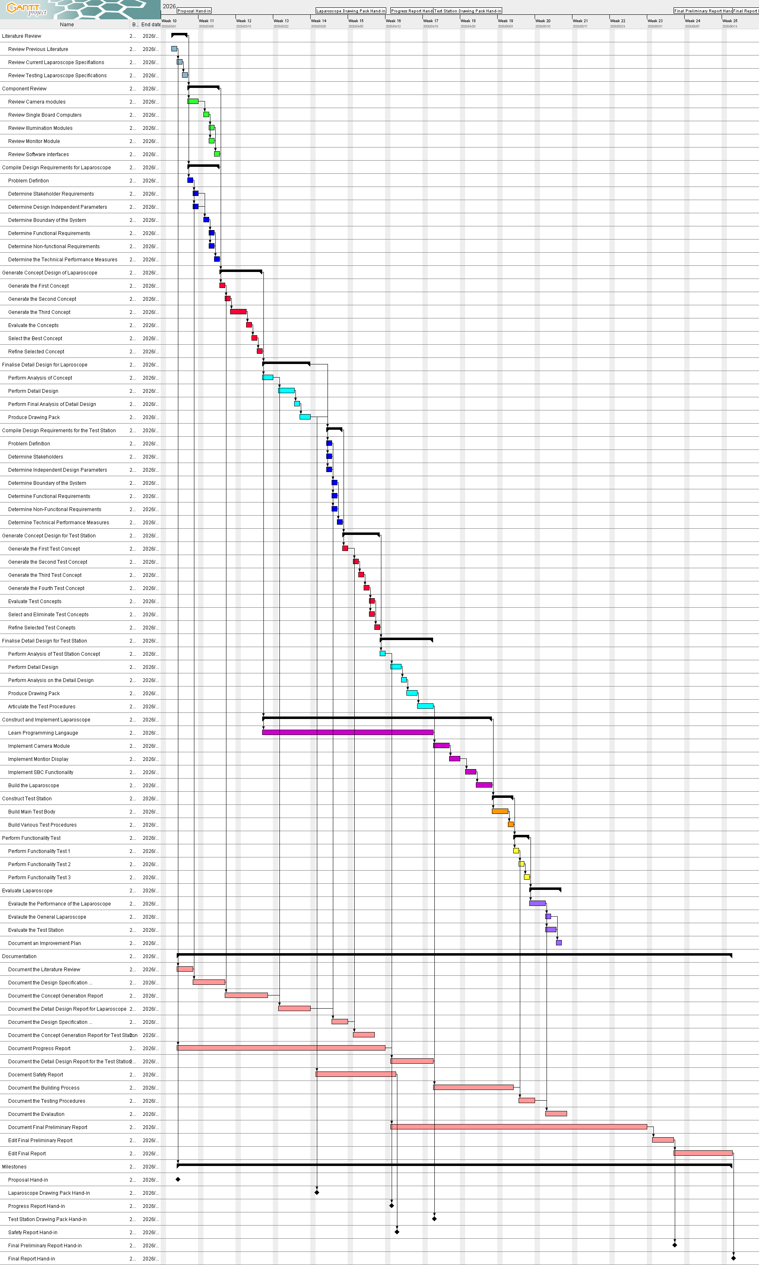
Admin/Hand-in/Proposal/Skripsie Gannt Chart.png
