pwbsu/Raspberry-Pi-Laparoscope/Documents/Prelimanry Report/figs/S1-1.jpg

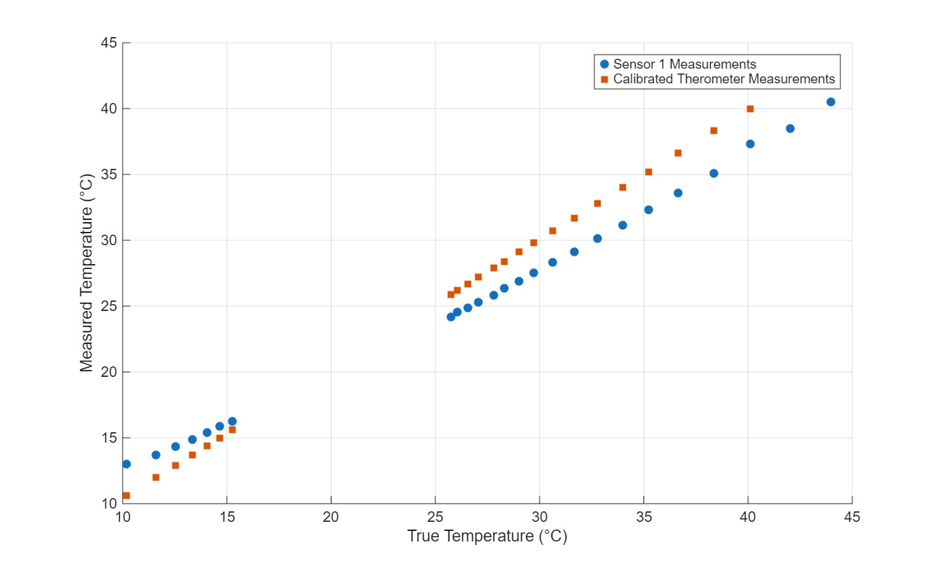
Documents/Prelimanry Report/figs/S1-1.jpg
