pwbsu/Raspberry-Pi-Laparoscope/Documents/Prelimanry Report/figs/System Boundary.png

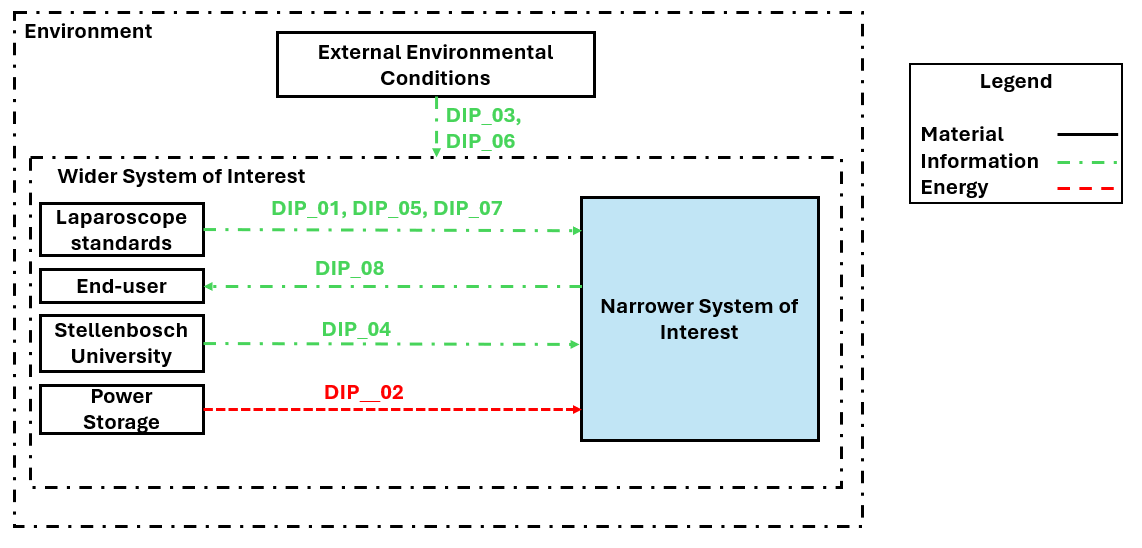
Documents/Prelimanry Report/figs/System Boundary.png
