pwbsu/Raspberry-Pi-Laparoscope/Skripsie Topic.png

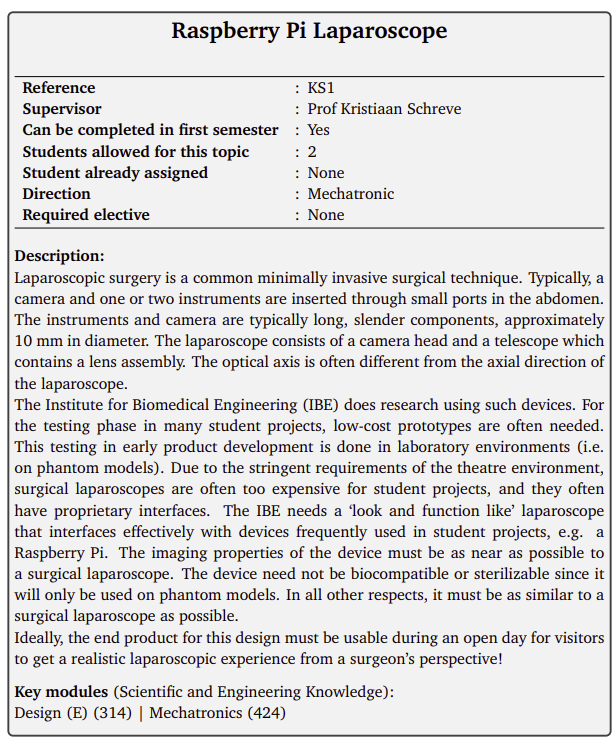
Skripsie Topic.png
