pwbsu/Raspberry-Pi-Laparoscope/Documents/Detail Design/Component List.xlsx

Component | Supplier | Quantity | Modified | Link | Notes
Heat Pipe Ø3 mm, 250 mm | RS Component | 1 | No | https://za.rs-online.com/web/p/heatsinks/8670907
Heat Pipe Ø3 mm, 100 mm | RS Component | 1 | No | https://za.rs-online.com/web/p/heatsinks/8670890
Heat Sinks | RS Component | 2 | Yes | https://za.rs-online.com/web/p/heatsinks/1846747
Copper Coupler, Part 1 | TBD | 1 | Yes
Copper Coupler, Part 2 | TBD | 1 | Yes
PTFE heat shrink tubing | RS Component | 1 | Yes | https://za.rs-online.com/web/p/heat-shrink-tubing/2345956 | Heat shrink sleeve requires a heat gun to apply to the design
Axail fan | RS Component | 2 | No | https://za.rs-online.com/web/p/axial-fans/6688805
Epoxy | TBD | 1 | No |  | Check availability from the university
Thermal Paste | TBD | 1 | No |  | Check availability from the university
Stainless steel outer cover | TBD | 1 | No
Solder | Own supplies | 1 | No
Festo tubing | University | 10 m | No |  | RS Components sells products, but sells in bags of 50 meters. Cost is then R1000
Festo fitting | RS Component or University | 4 | No | https://za.rs-online.com/web/p/pneumatic-fittings/2892036
Handle Cover 1 | Own supplies | 1 | Yes |  | Material required to manufacture: ABS
Handle Cover 2 | Own supplies | 1 | Yes |  | Material required to manufacture: ABS
Handle Cover 3 | Own supplies | 2 | Yes |  | Material required to manufacture: ABS
Screws and bolts and heat inserts | Own supplies | 1 | No
