pwbsu/Raspberry-Pi-Laparoscope/Research/Components lists/Camera modules.xlsx

Sheet: Micro Robotics Products
Product Description | Brand | Product Code | Cost | Built in LED | Resolution | USB | Diameter | Viewing angle | Link
DF Robot 3-in-1 Endoscope Camera | DF Robot | FIT0819 | 457.7 | Yes | 1200 P | Yes | 8 mm | 70 | https://www.robotics.org.za/FIT0819?search=camera
Raspberry Pi Zero V1.3 Mini Camera 5 MP OV5647 | Waveshare | W12039 | 227.2 | No | 1080 P | No | N/A | 72.4 | https://www.robotics.org.za/W12039?search=camera

Sheet: Communica
Product Description | Brand | SKU | Cost | Built in LED | Resolution | USB | Diameter | Viewing angle | Link
ITE PCDuino V3 Camera Module 5MP | Communica | ITE PCDUINO V3 CAMERA MODULE 5MP | 378.29 | No | 720 p | No | N/A | N/A | https://www.communica.co.za/products/ite-pcduino-v3-camera-module-5mp?variant=31071606931529

Sheet: DIYelectronics
Product Description | Brand | SKU | Cost | Built in LED | Resolution | USB | Diameter | Viewing angle | Link
ZeroCam Fisheye Module for Raspberry Pi Zero- 120 Degree 5MP | Waveshare | 9RASPZCAM120 | 316 | No | 1080 P | No | N/A | 120 | https://www.diyelectronics.co.za/store/accessories/4049-zerocam-fisheye-module-for-raspberry-pi-zero-120-degree-5mp.html

Sheet: Waveshare
Product Description | Brand | SKU | Cost ($) | Built in LED | Resolution | USB | Diameter | Viewing angle | Link | Notes
Rpi FPC Camera, Mini Size | Waveshare | 14038 | 25.99 | No | 1080 p | No | N/A | 69.8 | https://www.waveshare.com/product/raspberry-pi/cameras/rpi-fpc-camera.htm | Both these products have a dimensions of 11.5mm for its width. But it is not certain wherther if it is the dimension of the camera or the wide circuit board at the other end of the camera module.
Raspberry Zero V1.3 mini Camera | Waveshare | 12039 | 13.99 | No | 1080 p | No | N/A | 69.8 | https://www.waveshare.com/product/raspberry-pi/cameras/rpi-zero-v1.3-camera.htm
Note:
Waveshare has a wide range of available lenses that can be used for this project. All of these lense can be used with the M12 camera module. However, there diameters are to large

Sheet: Britech CMOS
Product Description | Brand | SKU | Cost ($) | Built in LED | Resolution | AV image processing | USB | Diameter | Viewing angle | Depth of field | Camera Module length | Cable length | Link
1.8mm USB Medical Endoscope Camera Module | Britech CMOS | CBT-400P-E1.8 |  | No | 0,16 MP (400 x 400 @ 30 fps) | Yes | Yes | 1.8 mm | 120 or 80 | 3-100 mm or 5 mm- inf or 5-20 mm | 5 mm | 0-3 m | https://cbritech.com/product/1-8mm-usb-medical-endoscope-camera-module/
1080 P OV2740 CMOS Sensor USB Micro Endoscope Camera Module System | Britech CMOS | CBT-1080P-E6.0 |  | Yes (4) | 2 MP (1920 x 1080 @ 60 fps) | Yes | Yes | 6 mm | 140 | 8-80 mm | 13 mm | 0-3 m | https://cbritech.com/product/1080p-ov2740-cmos-sesnor-usb-micro-endoscope-camera-module-system/
2.8mm OV6930 CMOS Sensor Medical Endoscopy Camera Module | Britech CMOS | CBT-400P-E2.8 |  | Yes (4) | 0.16 MP (400 x 400 @ 30 fps) | Yes | Yes | 2.8 mm | 120 | 10-100 mm or 3-50 mm (Customizable) | 8 mm | 50 mm- 3 m | https://cbritech.com/product/2-8mm-ov6930-cmos-sensor-medical-endoscopy-camera-module/
2mm OVM6949 Omnivision 400 x 400 CMOS Sensor Endoscope Camera Module | Britech CMOS | CBT-400P-E2.0 |  | Yes (4) | 0.16 MP (400 x 400 @ 30 fps) | Yes | Yes | 2 mm | 120 or 100 | 5 - 80 mm or 5 mm - inf | 5 mm | 0-3 m | https://cbritech.com/product/2mm-ovm6946-cmos-sensor-endoscope-camera-module/
2 MP 60 fps USB OCH2B10 Endoscope Camera Module for industrial, medical | Britech CMOS | 1500P-E5.0/1500P-E3.9 |  | Yes (4) | 0.922 MP (1280 x 720 @ 30 fps) | No | Yes | 5 mm | 120 | 5-50 mm | 15 mm | 1 m | https://cbritech.com/product/2mp-60pfs-usb-och2b10-endoscope-camera-module-for-industrialmedical/
Pipe Inspection Endoscope Camera for PC, Android, OS Iphone | Britech CMOS | 720P-3.9IN |  | Yes(6) | 0.922 MP (1280 x 720 @ 30 fps) | No | Yes | 3.9 mm | 100 or 75 or 60 | 10-50 mm or 30 mm - inf | N/A | 1 m or 2 m or 3 m or 5 m | https://cbritech.com/product/3-in-1-usb-industrial-borescope-3-9mm-ip67-flexible-snake-pipe-inspection-endoscope-camera-for-pc-android-os-iphone/
3.2 mm Endoscope Camera Module 720 P USB for medical industrial | Britech CMOS | CBT-400P-E3.2 |  | No | 0.922 MP (1280 x 720 @ 30 fps) | No | Yes | 3.2 mm | 120 | 10-100 mm or 5-80mm | 11 mm | 10-3000m | https://cbritech.com/product/3-2mm-endoscope-camera-module-720p-usb-for-medical-industrial/
3.9 mm 720 P Endoscope Camera Module USB Control LED brightness for andriod, windows, PC and linux | Britech CMOS | CBT-720P-E3.9V2.0 |  | Yes(6) | 0.922 MP (1280 x 720 @ 30 fps) | No | Yes | 3.9 mm | 100 or 120 | 10-50 mm or 5 mm - 50 mm | N/A | N/A | https://cbritech.com/product/3-9mm-720p-endoscope-camera-module-usb-control-led-brightness-for-android-windows-pc-linux/
4.5 mm 720 P Endoscope Camera Module MIPI/USB Output for industrial Inspection | Britech CMOS | N/A |  | Yes(6) | 0.922 MP (1280 x 720 @ 30 fps) | No | Yes | 4.5 mm | 76 | 30 - 400 mm | 22.4 mm | None | https://cbritech.com/product/4-5mm-720p-endoscope-camera-module-mipi-usb-output-for-industrial-inspection/
5 MP Endoscope Camera android & USB camera module with LEDs | Britech CMOS | N/A |  | Yes(6) | 5 MP (2592 x 1944 @ 30 fps) | No | Yes | 7 mm | 86 | 50 - 400 mm | 35 mm | None | https://cbritech.com/product/5mp-endoscope-camera-android-usb-camera-module-with-leds/
720 P 3.3 mm USB ENT Endoscope Camera Module for medical industrial | Britech CMOS | CBT-720P-E3.3 |  | Yes(4 or 6) | 0.922 MP (1280 x 720 @ 30 fps) | No | Yes | 3.3 mm | 100 or 120 | 5-80 mm or 10-100 mm | N/A | N/A | https://cbritech.com/product/720p-3-3mm-usb-ent-endoscope-camera-module-for-medical-industrial/
720 P Diameter 4.5 mm VGA TV CVBS System Endoscope Camera Module | Britech CMOS | CBT-720P-E5.5 |  | Yes(4) | 0.378 MP (720 x 525 @ 60 fps) | No | N/A | 5.7 mm | 54 | 20-70 mm or 1m-ing | 25.1 mm | None | https://cbritech.com/product/720p-diamerter-4-5mm-vga-tv-cvbs-system-endoscope-camera-module/
Out diameter 3.5 mm 720 P Medical Endoscope Camera Module | Britech CMOS | CBT-720P-E3.5 | 120+48 | Yes(4) | 0.922 MP (1280 x 720 @ 30 fps) | Yes | Yes | 3.5 mm | 120 or 100 | 10-100 mm or 5-80mm | 11 mm | 0-3m | https://cbritech.com/product/out-diameter-3-5mm-720p-medical-endoscope-camera-module/
720P USB 3.9 mm Endoscope Camera Module for industrial, medical or animal | Britech CMOS | CBT-720P-E3.9 |  | Yes(4) | 0.922 MP (1280 x 720 @ 30 fps) | Yes | Yes | 3.9 mm | 100 | 10-100 mm | 11 mm | 600 mm | https://cbritech.com/product/720p-usb-3-9mm-endoscope-camera-module-for-industrialmedical-animal/
OV9734 USB OD3.3 mm Medical Endoscope Camera Module | Britech CMOS | CBT-720P-E3.3 |  | Yes(4) | 0.922 MP (1280 x 720 @ 30 fps) | No | Yes | 3.3 mm | 140 or 120 or 100 | 30-100mm or 8-50 mm or 10-50 mm | 13 mm | 0-2000 mm | https://cbritech.com/product/ov9734-usb-720p-od3-3mm-medical-endoscope-camera-module/

Sheet: IADIY
Product Description | Brand | Model | Cost ($) | Built in LED | Resolution | MIPI | USB | Dimension | Viewing angle | Depth of field | Camera Module length | Cable length | Link | Notes
Endoscope Camera module 0,3M | IADIY | SCM03M30D5.5U | 23 | Yes (6) | 0.3 MP (640 x 480 @ 30 fps) | No | Yes | Ø 5.5 mm | 60 | 30 - 50 mm | 25 mm | 1.5 m | https://www.iadiy.com/endoscope-camera-module-SCM03M30D5.5U
Endoscope Camera Module 2M | IADIY | SCM2M30D8U | 48 | Yes(6) | 2 MP (1920 x 1080 @ 30 fps) | No | Yes | Ø 8 mm | 80 | 30 - 50 mm | 28 mm | 1.5 m | https://www.iadiy.com/new-product/endoscope-camera-module-SCM2M30D8U
MIPI CSI-2 Camera Module 0.3 M VGA Global shutter | IADIY | MCM03M180M7 | 19 | No | 0.3 MP (640 x 480 @ 180 fps) | Yes | No | 8.1 x 8.1 mm | 60 or 80 or 120 or 160 | N/A | None | 50 mm | https://www.iadiy.com/global-shutter-mipi-camera-module-sc035hgs | This camera module can only be used if the viewing angle is between 61 and 119 degrees
MIPI CSI-2 Camera Module 5 M | IADIY | MCM5M120M6F2 | 20 | No | 2 MP (1920 x 1080 @ 30 fps) | Yes | No | 8.65 x 8.65 mm | 68 or 80 or 120 or 160 | N/A | None | 78 mm | https://www.iadiy.com/mipi-csi-2-camera-module-ov5640 | This camera can only be used when the viewing angle is 90 degrees.
MIPI CSI-2 Camera Module 13 M | IADIY | MCM13M60M7 | 35 | No | 13 MP (4208 x 3120 @ 30 fps) | Yes | No | 8.65 x 8.65 mm | 82 or 120 or 135 | N/A | None | 45 mm | https://www.iadiy.com/mipi-camera-module-manufacturer-imx258 | This camera can only be used when the viewing angle is 90 degrees.
Micro Diameter Endoscope Camera Module 1M | IADIY | SCM1M30D3.9U | 43 | Yes | 0.921 MP (1280 x 720 @ 30fps) | No | Yes | Ø 3.9 mm | 65 or 100 or 120 or 140 | 5 - 100 mm | 27 mm | 1.5 m | https://www.iadiy.com/endoscope-camera-module-SCM1M30D3.5U

Sheet: Vision Meta
Product Description | Brand | Model | Cost ($) | Built in LED | Separated or integrated | Resolution | MIPI | USB | Dimension | Viewing angle | Depth of field | Camera Module length | Cable length | Link | Notes
1.05mm 2.0mm 2.8mm OV6949 Endoscope Micro Module 120 FOV | Vision Meta | VM-YJOV6946X |  | Yes (4) and No | Undetermined | 0.16 MP (400 x 400 @ 30 fps) | Yes | Yes | Ø 1.1 mm or 2 / 2.4 mm | 120 | 5-50 mm | 5 mm | Undetermined | https://www.visionmeta.com/product/1-05mm-2-0mm-2-8mm-ov6946-endoscope-micro-module-120fov/ | This camera is customizable. You can select if there is LED's, or steel tube or nothing except the camera
3.0 mmES101 1MP Medical Endoscope Module HD Imaging | Vision Meta | VM-YJES101X | 120 | Yes | Seperated | 1 MP (1000 x 1000 @ 80 fps) | Yes | Yes | Ø 3 mm | 90 | Undetermined | Undetermined | 1500 | https://www.visionmeta.com/product/3-0mm-es101-1mp-medical-endoscope-module-hd-imaging-for-medical-applications/
1 MP 3.5 OV9374 HD Endoscope medical camera module | Vision Meta | VM-EOV9734 | 98 | No | Seperated | 1 MP (1280 x 720 @ 25 fps) | Yes | Yes | Ø 3.5 mm | 90 | Undetermined | Undetermined | Undetermined | https://www.visionmeta.com/product/11mp-1-9-ov9734-usb-hd-endoscope-camera-module-for-medical/
1 MP 3.5 OV9374 HD Endoscope medical camera module | Vision Meta | VM-EOV9734 | 60 | No | Integrated | 1 MP (1280 x 720 @ 25 fps) | No | Yes | Ø 3.5 mm | 90 | Undetermined | Undetermined | Undetermined | https://www.visionmeta.com/product/11mp-1-9-ov9734-usb-hd-endoscope-camera-module-for-medical/
