pwbsu/Raspberry-Pi-Laparoscope/Research/Components lists/Display screen modules.xlsx

Sheet: Micro Robotics
Model | Code | Cost | Size | Display area | Resolution | Touch screen | Refresh rate | Link | Notes
Wave 7'' IPS Touch with DVI Interface | W22676 | 1055.7 | 173 x 103 x 4,2 mm | 154,2 x 85,92 mm | 1024 x 600 | Yes | 60 Hz | https://www.robotics.org.za/W22676?search=display&page=7 | Included in packaging: 1 Screen, 1 FPC Cable, 1 adapter board, 1 USB-A to USB-C cable, 1 HDMI to HDMI Cable, 1 HDMI to Micro HDMI
Wave 7'' IPS Touch with DVI Interface and Cable | W22672 | 848.7 | 164 x 97 x 3,5 mm | 154,21 x 85,92 mm | 1024 x 600 | No | 60 Hz | https://www.robotics.org.za/W22672?search=display&page=7 | Included in packaging: 1 Screen, 1 FPC Cable, 1 adapter board, 1 USB-A to USB-C cable, 1 HDMI to HDMI Cable, 1 HDMI to Micro HDMI
Wave 5'' Capacitive Touch Display | W28919 | 1377.7 | 128 x 68,70 x 12 mm | 110,4 x 62,1 mm | 720 x 1280 | Yes | 60 Hz | https://www.robotics.org.za/W28919?search=display&page=7 | Included in packaging: 1 Screen, 1 Capacitive touch pen, 1 HDMI to Micro HDMI Adapter, 1 Type-A to Type-C cable - 1m, 1 HDMI flat cable - 1m
Wave 4.3'' IPS CAP Touch | W15932 | 1143.1 | N/A | N/A | 800 x 480 | Yes | N/A | https://www.robotics.org.za/W15932?search=display&page=7 | Included in packaging: 1 Screen, 1 HDMI cable, 1 USB type A to micro B cable, 1 HDMI adapter, 1 USB adapter, 1 screws pack
Wave 2.4'' Display SPI 65K colour | W18366 | 243.8 | 70,50 x 43,3 mm | 36,72 x 48,96 mm | 240 x 320 | Yes | N/A | https://www.robotics.org.za/W18366?search=display&page=6 | Included in packaging: 1 Screen, 1 PH2.0 8PIN 20 CM cable
Wave 2'' IPS Touch Display | W29063 | 296.7 | 37,1 x 58,8 mm | 30,6 x 40,8 mm | 240 x 320 | Yes | N/A | https://www.robotics.org.za/W29063?search=display&page=6 | Included in packaging: 1 Screen, 1 GH1.25 15-Pin cable
Wave 10.1 inch LCD 024X600 with LVDS Interface - No Touch | W-101-CAP-T-TYPED | 837.2 | N/A | 222,72 x 125,28 mm | 1024 x 600 | No | N/A | https://www.robotics.org.za/W-101-CAP-T-TYPED?search=display&page=6 | Included in Packaging: 1 Screen, 1 40 pin FFC Cable
TFT 3.2 Inch Display with Touch SPI - ILI9341 | TFT-32-SPI-ILI9341 | 287.5 | 55,04 x 89,3 mm | 48,6 x 89,3 mm | 320 x 240 | Yes | N/A | https://www.robotics.org.za/TFT-32-SPI-ILI9341?search=display&page=5 | Included in packaging: 1 Screen, 1 Stylus
ESP32-S3 Parallel TFT Touch 3.5'' Display - ILI9488 | ESP32S335D | 1086.75 | 66 x 84,3 x 12 mm | 60 x 80 mm | 480 x 320 | Yes | N/A | https://www.robotics.org.za/ESP32S335D?search=display&page=2 | Included in packaging: 1 Screen

Sheet: Communica
Model | SKU | Cost | Display area | Resolution | Touch screen | Link
WVS 7'' R touch display 1024x600 | WVS 7IN R TOUCH DISPLAY 1024X600 | 1130 | 7 inch | 1024 x 600 | Yes | https://www.communica.co.za/products/wvs-7in-r-touch-display-1024x600?variant=40193485668425
WVS 5.5'' Ctouch displ 1080x1920 | WVS 5.5IN CTOUCH DISPL 1080X1920 | 2290 | 5.5 inch | 1080 x 1920 | Yes | https://www.communica.co.za/products/wvs-5-5in-ctouch-displ-1080x1920
WVS 10.1'' Rtouch displ 1024x600 | WVS 10.1IN RTOUCH DISPL 1024X600 | 1695 | 10.1 inch | 1024 x 600 | Yes | https://www.communica.co.za/products/wvs-10-1in-rtouch-displ-1024x600
WVS 5'' Cap Touch displ 800x480 | WVS 5IN CAP TOUCH DISPL 800X480 | 1120 | 5 inch | 800 x 480 | Yes | https://www.communica.co.za/products/wvs-5in-cap-touch-displ-800x480
CMU Raspberry Pi 5'' touch TFT | CMU RASPBERRY PI 5IN TOUCH TFT | 850 | 5 inch | 800 x 480 | Yes | https://www.communica.co.za/products/cmu-raspbery-pi-5in-touch-tft
WVS 7'' Ctouch displ+C 1024x600 | WVS 7IN CTOUCH DISPL+C 1024X600 | 1250 | 7 inch | 1024 x 600 | Yes | https://www.communica.co.za/products/wvs-7in-ctouch-displ-c-1024x600
