pwbsu/Raspberry-Pi-Laparoscope/Documents/Design specifications for laparoscope/Design Requirements.xlsx

Sheet: Stakeholder Requirements
Stakeholder ID | Stakeholder | Classification | Description | Life Cycle Stages | Key Interest/Needs
SH_01 | Dr Diayar | Inderect | The doctor that recommend the development of the system | Concept | The functional development of the system
SH_02 | Prof Schreve | Secondary | Supervisor of the project | All stages | The functional development of the system, and the engineering design methodology followed to develop the system
SH_03 | Medical trainees | Primary | The personal that will use the developed system to improve their surgical abilities | Operation | The low-cost production of the system and the easy operations of the system
SH_04 | Hardware suppliers | Secondary | The suppliers of the hardware components for the system | Design, Installation | Technical specifications of the hardware components
SH_05 | Structural manufacturers | Secondary | Personnel responsible for the construction of structural components of the system | Design, Installation | Technical specifications of the stuctural components
SH_06 | Stellenbosch University | Secondary | Main financial supplier and main management team of the project | All stages | The cost of the project, acedemic procedures followed and safe operations during all stages of the project
SH_07 | Future researchers | Primary | Future personal that will use the developed system or select componenets of the system to perform further reaserchers | Operation, Maintenance | The techincal specifications of the developed system, the technical conditions of systems hardware components
SH_08 | Construction and maintenance staff | Secondary | Personnel responsible for the construction and maintenance for the entire system | Installation, Maintenance | System design and building procedures, systems maintenance procedures
SH_09 | Design team | Secondary | Personnel responsible for the design of the entire system | Design | System requirement and hardware physical properties
SH_10 | Programming team | Secondary | Personnel for the software component of the entire system | Design, Installation | System requirements and hardware software cabilities
SH_11 | Potential student attendees | Primary | Potential students that will use the system to "perform" surgical procedures | Operation | Easy operations and useability of the system

Sheet: Design Independent Parameters
DIP_ID | Design Independent Parameter Description | Value/Range | Reference | Notes | Links
DIP_01 | Laparoscope maximum diameter | Ø < 10 mm | Supervisor | The outer diameter of laparoscope, given dimension by supervisor.
DIP_02 | Grid electricity availibility | 230 V, 15 Ampere at 50 Hz | worldstandards.eu |  | https://www.worldstandards.eu/electricity/plug-voltage-by-country/south-africa/
DIP_03 | Ambient operating temperatures range (Stellenbosch) | 2 C° - 42 C° | weather-and-climate.com | The maximum and minimum temperatures it should be able to operate in stellenbosch university climate | https://weather-and-climate.com/average-monthly-min-max-Temperature,stellenbosch,South-Africa
DIP_04 | Laparoscopes total building cost | R 6000.00 | Stemlearn (2026) | The total available cost to build the laparoscope
DIP_05 | Laparoscope illuminance produced | 40 000 LUX - 160 000 LUX | IEC 60601-2-41:2021 |  | https://webstore.iec.ch/en/publication/62677
DIP_06 | Relative maximum humidity in operating rooms | < 81% | weather-and-climate.com | Humidity levels the component should can handle, ISO standards were checked, but their relative humidity is lower than the maximum humidity for stellenbosch. Design the system for the worst case cenario. | https://weather-and-climate.com/average-monthly-Rainfall-Temperature-Sunshine,stellenbosch,South-Africa
DIP_07 | Maximum deviation of specified viewing angle | 10° | ISO 8600-1:2025
DIP_08 | Frequency of real-time digital images updates | 30 Hz - 60 Hz | karlstorz.com | Certain cameras that can be purchased has a maximum frame rate of 30 Hz, but the storz karl medical laparoscope that can be purchased has a frame rate of 50/60 Hz | https://www.karlstorz.com/za/en/product-detail-page.htm?productID=1000108799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

Sheet: Functional Requirement
FR_ID | Functional Requirement Description | Primary/Derived
FR_1 | User interface | Primary
FR_2 | System processor | Primary
FR_3 | Power supply | Primary
FR_4 | Operate Camera Module | Primary
FR_4.1 | Specify camera settings | Derived
FR_4.2 | Specify light intensity | Derived
FR_4.3 | Capture digital image | Derived
FR_5.0 | Display real-time images | Primary
FR_6.0 | Store system data | Primary

Sheet: Non-functional Requirement
NFR_ID | Non-Function Requirement | Description | Reference | Links
NFR_01 | Relevant complaince | The design of the system should meet the relevant prescribed standard for this project, to ensure that the laparoscope meets all physical capabilities and functionality of a real laparoscope | ISO 8600 & IEC 60601-1-41
NFR_02 | Documentation | The design, implementation, construction, maintenance and testing procedures for the system should be thuroughly documented | Theunissen & van Heesch & Avgeriou | https://www.sciencedirect.com/science/article/pii/S095058492100183X
NFR_03 | Availability | The components for this project should be available to purchase if a component breaks or should be replaced
NFR_04 | Adjustable | The system design should be developed that distinct features can be changed without creating large external costs
NFR_05 | Usability | System should be easy to operate for limited-training users

Sheet: Technical Performance Measures
FR_ID | Function | TPM_ID | TPM Description | TPM Target Value(s) | Reference for Target | TPM Reasoning
FR_1.0 | User interface | TPM_01 | Minimum user interface input(s) | ≥ 1 input |  | The bare minimum for the laparoscope to function properly with user inputs is to at least install a on or off switch. It is the bare minimum required for this project.
 |  | TPM_02 | Minimum user interface signals(s) | ≥ 1 singal light |  | For the operater to know the laparoscope is still functioning properly, without looking at the display screen or light module at the end of the laparoscope, there should be at least 1 signal light on the laparoscope to indicate that the system is receiving power.
FR_2.0 | System processor | TPM_03 | Minimum GPIO pins | ≥ 1 GPIO Pin |  | To operate the signal lights the microcontroller or SBC will require GPIO Pin to push current into the signal lights. Thus, the minimum required is the minimum of the laparoscope signal lights.
 |  | TPM_04 | System start up cycle duration | ≤ 2 s |  | This is dependent on the component selected and the different interfaces selected between the different components.
FR_3.0 | Power supply | TPM_05 | Total duration of power supply required | ≥ 6.7 hours | Shusan, Mohamed, Magos (1999) | The system should be able to power on for long durations of times. The total amount of time it should be powered on is the duration of a laparoscopic surgery.
FR_4.0 | Operate camera module | TPM_06 | Amount of camera modules | 1 - 2 camera modules |  | The system requires at least 1 laparoscopic camera. A second camera module can help the system achieve 3D visualization. Any additional cameras would be redundant for this project.
 |  | TPM_07 | Working length of the system | 300 mm |  | The system design should be similar to current laparoscopes. Current laparoscope designs has a working distance of 300 mm. The working distance is the distance of the rod that can be inserted into the patient's body.
 |  | TPM_08 | Viewing angle of camera module | 30° |  | Different laparoscope products have different viewing angles. Some has a viewing angle of 0°, while there are products that has a viewing angle of 90°. However a common viewing angle is 30°, which is the value that will be pursued in this project.
FR_4.1 | Configure camera properties | TPM_09 | Focus depth of the camera module | 30 mm - 80 mm |  | The distance between the camera sensor of the laparoscope and the object that is being captured visually. The system should be designed so that it can capture images of the object in focus.
FR_4.2 | Configure light intensity | TPM_10 | Illumanation of system | 40 000 LUX - 160 000 LUX | IEC 60601-2-41:2021 | The total illumanation required per medical theaters.
 |  | TPM_11 | Maximum surface temperature | ≤ 41 °C | IEC 60601-1 | The maximum temperature of the casing of the laparoscope tip
FR_4.3 | Capture digital image | TPM_12 | Minimum field of view | ≥ 70° |  | Smallest viewing angle applied to a laparscopic commercial product is 70°, while certain laparoscopes has a viewing angle larger than 70°
 |  | TPM_13 | Minimum resolution | 460 x 460 pixels |  | The minimum resolution for the camera module is determined by the first determining the maximum visible seen at the smallest fov, and multiply that value with how many pixels a millimeter area should represented: Pixel = Focus depth_(max)*sin(fov/2)*2*5 pixels/mm
FR_5.0 | Display real-time images | TPM_14 | Minimum resolution of display | 460 x 460 pixels |  | The minimum resolution of the display is the same as the minimum resolution of the camera.
 |  | TPM_15 | Maximum latency | 0.5 s |  | This value is subject to change based on the different components used for the system. Therefore, it is important to minimise the latensy of each component or interaction between different components. 0.5 s is just an absolute maximum latency that will be accepted.
FR_6.0 | Store system data | TPM_16 | Storage capacity | 68,56 GB |  | If the minimum resolution a image is 460 x 460 with RGB colour format, then 1 image requires 634.8 KB. (PxP*24/8) If the frame rate is 30 fps and this continued for 60 minutes, then a total space of 68,5584 Gb is required
