pwbsu/Raspberry-Pi-Laparoscope/Research/Components lists/Illumination hardware.xlsx

Sheet: Micro Robotics
Model | Code | Cost | Operating voltage | Forward current | Luminous intensity | Dimensions | Link
LED SMD 0603 - White (100 Pack) | LED-0603-WHI | 20.7 | 2 - 2,8 V | 20 mA | 45 - 180 mcd | 1,6 x 0,8 x 0,55 mm | https://www.robotics.org.za/LED-0603-WHI?search=white%20smd%20led
LED SMD 1206 - White (100 Pack) | LED-1206-WHI | 20.7 | 3,2-3,8 V | 100 mA | 200-850 mcd | 3,2 x 1,6 x 1,1 mm | https://www.robotics.org.za/LED-1206-WHI?search=white%20smd%20led

Sheet: Communica
Model | Code | Cost | Operating voltage | Forward current | Luminous intensity | Dimensions | Link
KPA-2106QWF-D | KPA-2106QWF-D | 4.51 | 3,5 - 4 V | 30 - 30 mA | 350 mcd | 2,1 x 0,6 x 1 mm | https://www.communica.co.za/products/kpa-2106qwf-d
KPTR-3216WF-A | KPTR-3216WF-A | 6 | N/A | N/A | N/A | N/A | https://www.communica.co.za/products/kptr-3216pwf-a
KPT-2012QWF-D | KPT-2012QWF-D | 6.1 | N/A | N/A | 250 cmd | N/A | https://www.communica.co.za/products/kpt-2012qwf-d
