pwbsu/Raspberry-Pi-Laparoscope/Research/Laparoscope Standards/Available Products Specifications.xlsx

Supplier | Product Name | Item number | Image sensor resolution | Weight | Outer Diameter | Direction of view | Working length | Frame Rate | Number of image sensors | Zoom function | 3D capabilities | Fluorescenece Imaging | Horizon Control | Field of View
Karl Storz - Endoskope | TIPCAM®1 Rubina® | 26606BCA | 4K | 420 g | 10.3 mm | 0° and 30 ° | 320 mm | 50/60 Hz | 2 | Digital zoom | Yes | Yes | Yes | N/A
Olympus | ENDOEYE 3D 10 mm | WA50080A | HD 3D Imaging | <1500 g | 10 mm | 0° and 30 ° | 330 mm | N/A | 2 | Digital zoom | Yes | Yes | Yes | 67 °
