pwbsu/Raspberry-Pi-Laparoscope/Documents/Detail Design/Arm Design/Bottom Clamp/Clips.3mf

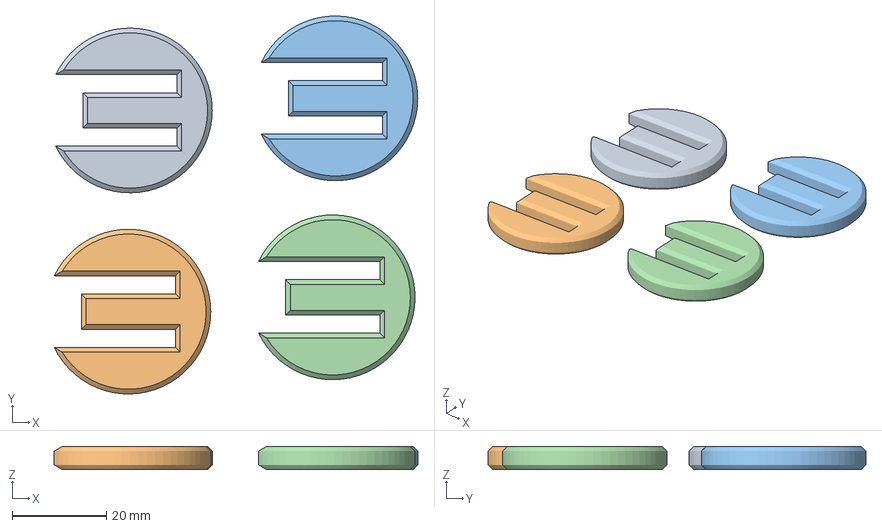
[picture p77: CAD file, 2026-05-25]
Documents/Detail Design/Arm Design/Bottom Clamp/Clips.3mf
77.2 x 80.3 x 4.90 mm
Clips.stl x 4
