pwbsu/Raspberry-Pi-Laparoscope/Documents/Detail Design/Box Design/Gridfinity/baseplate-10-10.stl

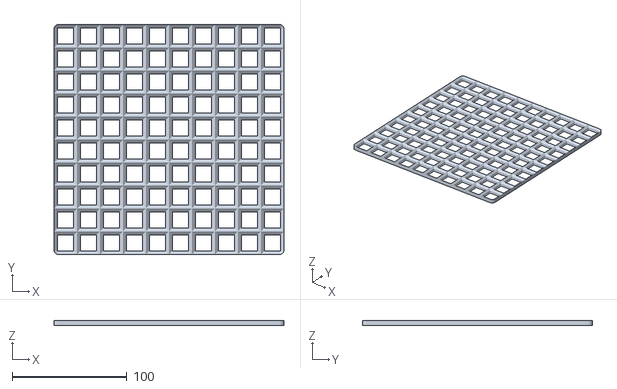
[picture p78: CAD file, 2026-05-25]
Documents/Detail Design/Box Design/Gridfinity/baseplate-10-10.stl
200.0 x 200.0 x 4.65
