pwbsu/Raspberry-Pi-Laparoscope/Documents/Detail Design/Building Parts/Front Bracket.stl

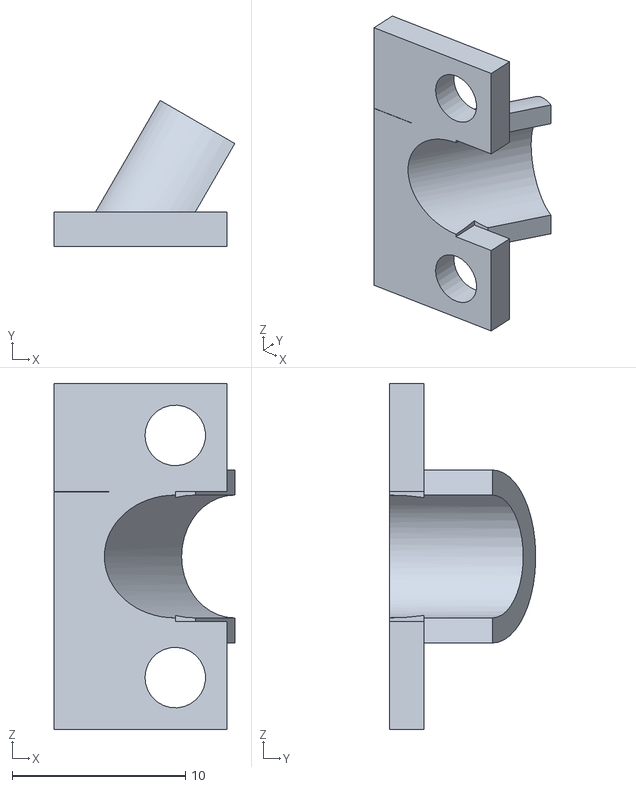
[picture p79: CAD file, 2026-05-25]
Documents/Detail Design/Building Parts/Front Bracket.stl
10.4 x 8.45 x 20.0
