pwbsu/Raspberry-Pi-Laparoscope/Documents/Detail Design/Arm Design/Bottom Clamp/Spacer.stl

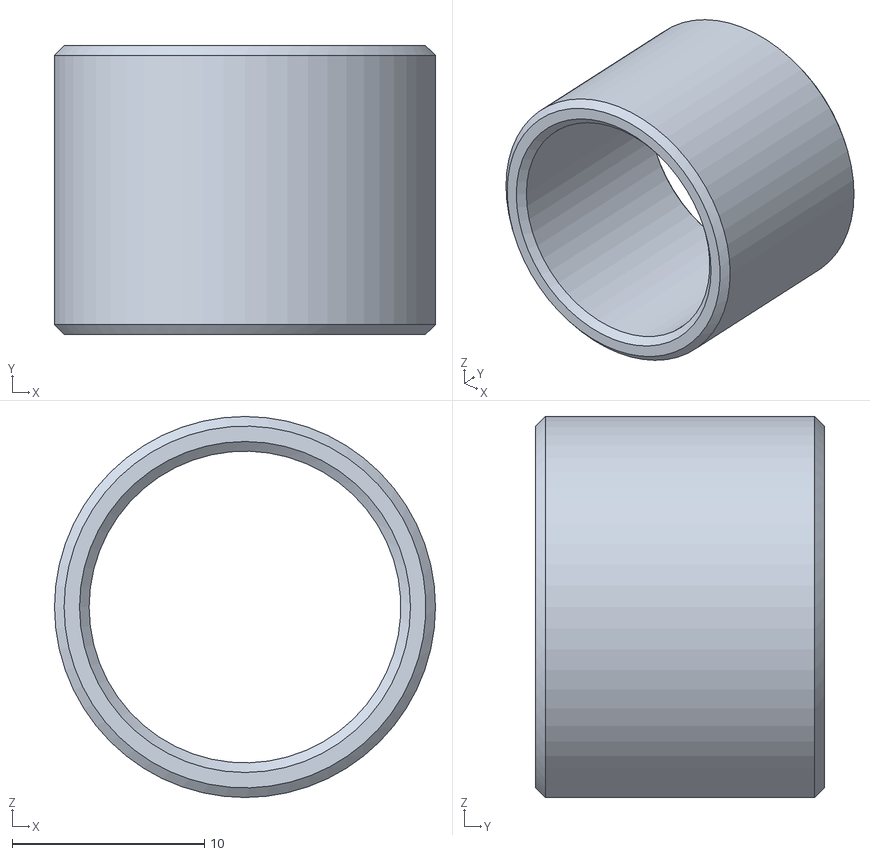
[picture p80: CAD file, 2026-05-25]
Documents/Detail Design/Arm Design/Bottom Clamp/Spacer.stl
19.8 x 15.0 x 19.8
