pwbsu/Raspberry-Pi-Laparoscope/Documents/Detail Design/Box Design/Gridfinity/baseplate-5-5.stl

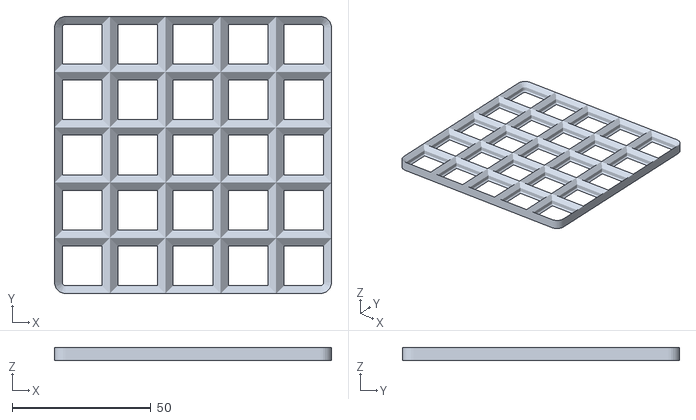
[picture p81: CAD file, 2026-05-25]
Documents/Detail Design/Box Design/Gridfinity/baseplate-5-5.stl
100.0 x 100.0 x 4.65
