pwbsu/Raspberry-Pi-Laparoscope/Documents/Detail Design/Building Parts/Top Bracket.stl

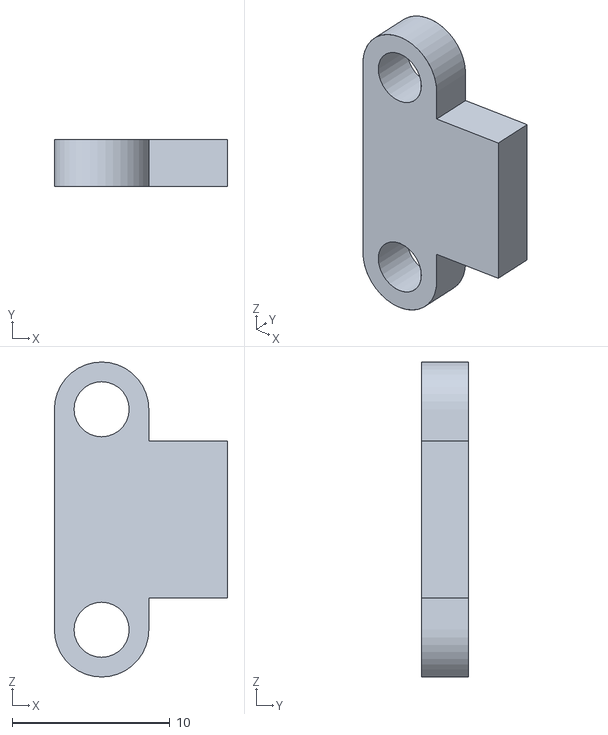
[picture p82: CAD file, 2026-05-25]
Documents/Detail Design/Building Parts/Top Bracket.stl
11.0 x 3.00 x 20.0
