pwbsu/Raspberry-Pi-Laparoscope/Documents/Detail Design/Arm Design/Bottom Clamp/Pin.stl

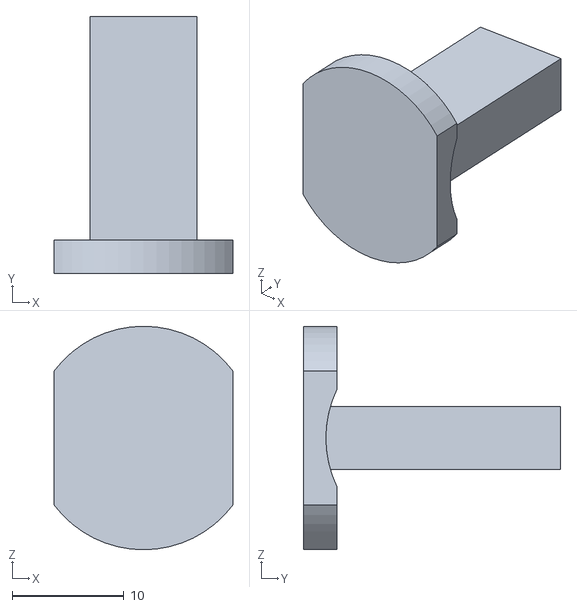
[picture p83: CAD file, 2026-05-25]
Documents/Detail Design/Arm Design/Bottom Clamp/Pin.stl
16.0 x 23.0 x 20.0
