pwbsu/Raspberry-Pi-Laparoscope/Documents/Detail Design/Building Parts/Belt Holder.stl

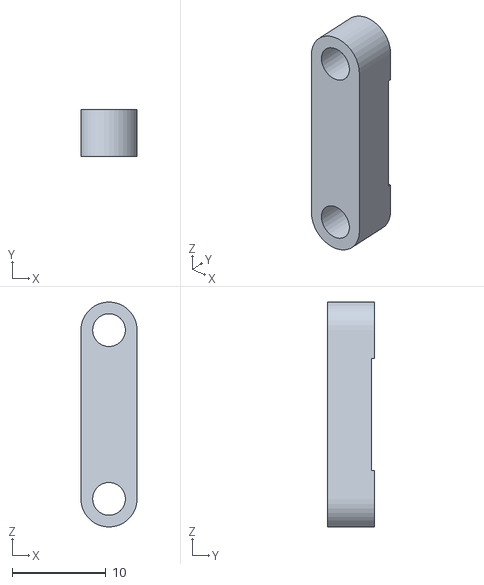
[picture p84: CAD file, 2026-05-25]
Documents/Detail Design/Building Parts/Belt Holder.stl
6.00 x 5.00 x 24.0
