pwbsu/Raspberry-Pi-Laparoscope/Documents/Detail Design/Building Parts/whoopwhoopfinalmag.3mf

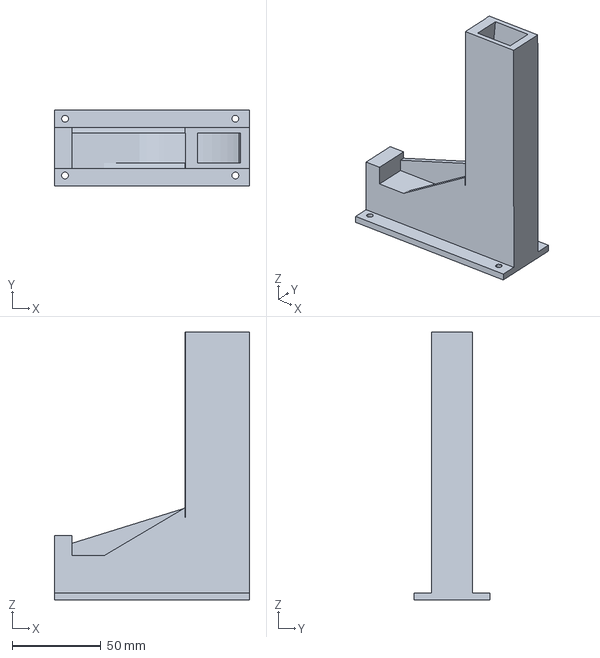
[picture p85: CAD file, 2026-05-25]
Documents/Detail Design/Building Parts/whoopwhoopfinalmag.3mf
110.0 x 43.0 x 151.1 mm
