pwbsu/Raspberry-Pi-Laparoscope/Documents/Detail Design/Arm Design/Bottom Clamp/Foot Swivel.stl

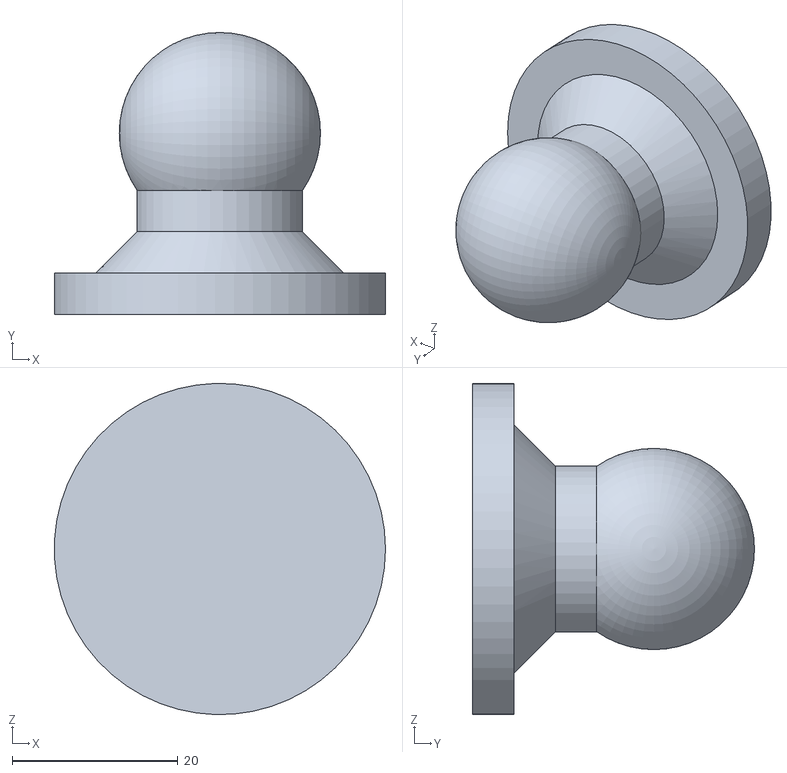
[picture p86: CAD file, 2026-05-25]
Documents/Detail Design/Arm Design/Bottom Clamp/Foot Swivel.stl
40.0 x 34.1 x 40.0
