pwbsu/Raspberry-Pi-Laparoscope/Documents/Detail Design/Building Parts/Camera Holder 1.stl

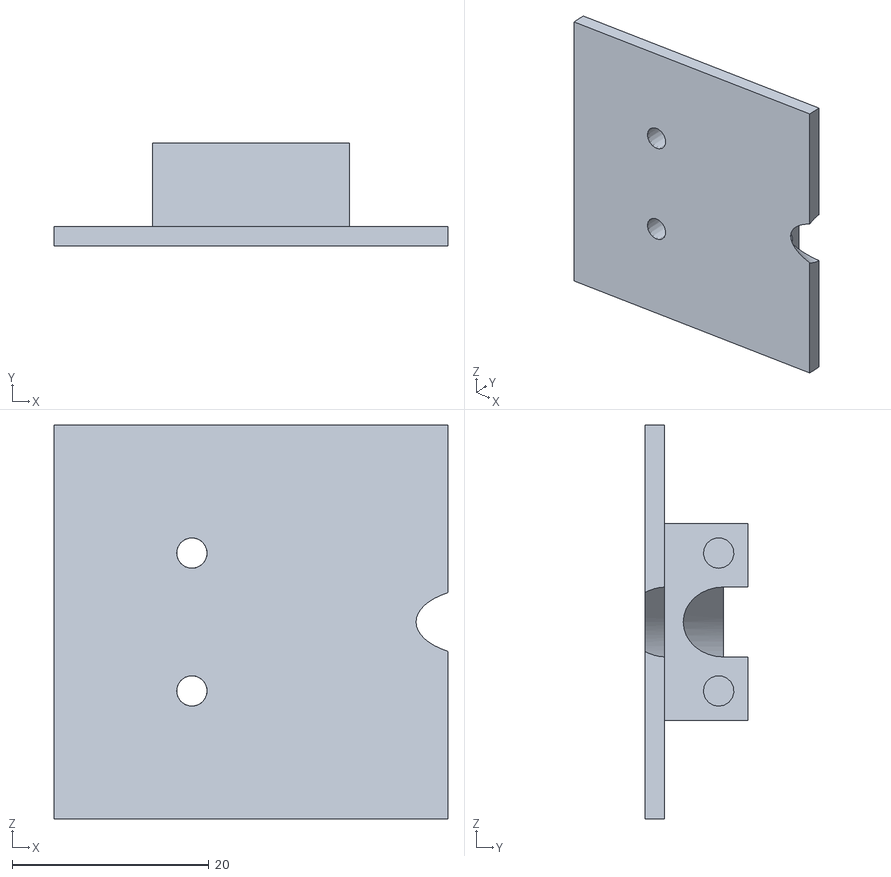
[picture p87: CAD file, 2026-05-25]
Documents/Detail Design/Building Parts/Camera Holder 1.stl
40.0 x 10.5 x 40.0
