pwbsu/Raspberry-Pi-Laparoscope/Documents/Detail Design/Arm Design/Bottom Clamp/Test Square.stl

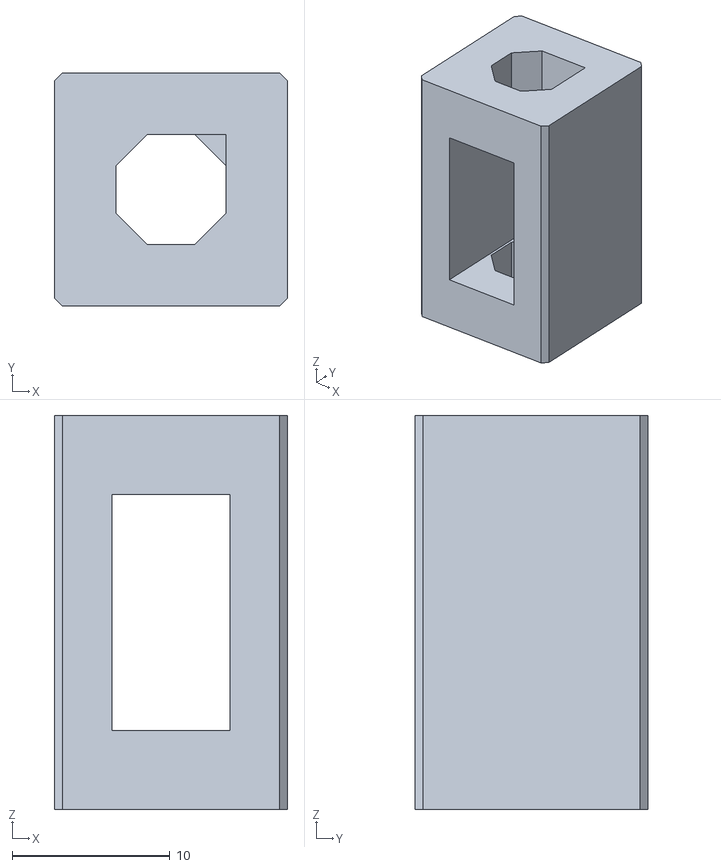
[picture p88: CAD file, 2026-05-25]
Documents/Detail Design/Arm Design/Bottom Clamp/Test Square.stl
14.8 x 14.8 x 25.0
