pwbsu/Raspberry-Pi-Laparoscope/Documents/Detail Design/Building Parts/Ring.stl

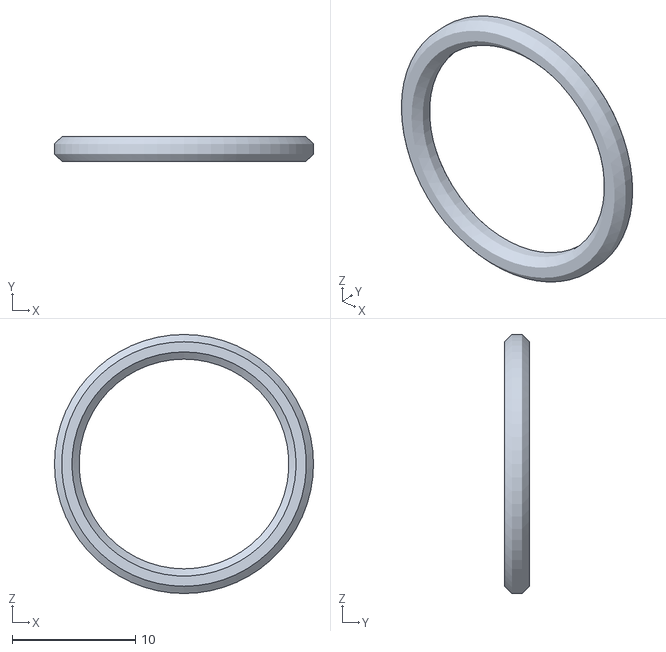
[picture p89: CAD file, 2026-05-25]
Documents/Detail Design/Building Parts/Ring.stl
21.0 x 2.00 x 21.0
