pwbsu/Raspberry-Pi-Laparoscope/Documents/Detail Design/Arm Design/Bottom Clamp/Top Frame.stl

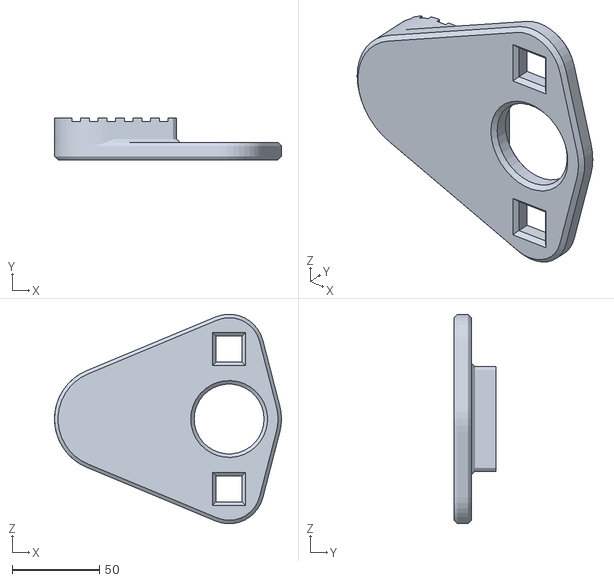
[picture p90: CAD file, 2026-05-25]
Documents/Detail Design/Arm Design/Bottom Clamp/Top Frame.stl
130.0 x 24.0 x 119.9
