pwbsu/Raspberry-Pi-Laparoscope/Documents/Detail Design/Arm Design/Bottom Clamp/Test2.stl

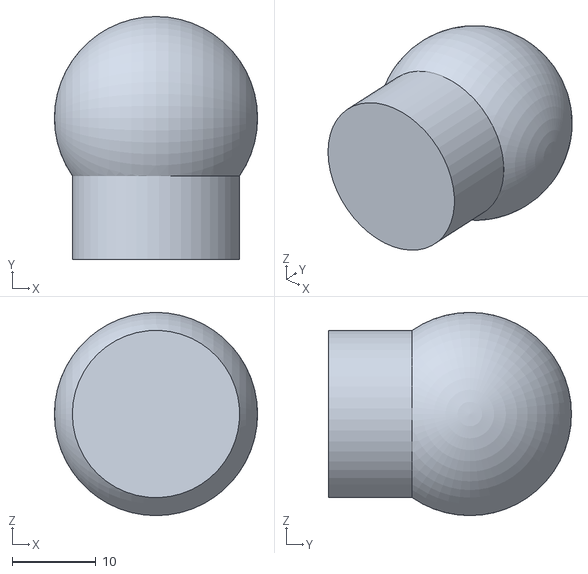
[picture p91: CAD file, 2026-05-25]
Documents/Detail Design/Arm Design/Bottom Clamp/Test2.stl
24.3 x 29.1 x 24.3
