pwbsu/Raspberry-Pi-Laparoscope/Documents/Detail Design/Arm Design/Bottom Clamp/Foot Stamp.stl

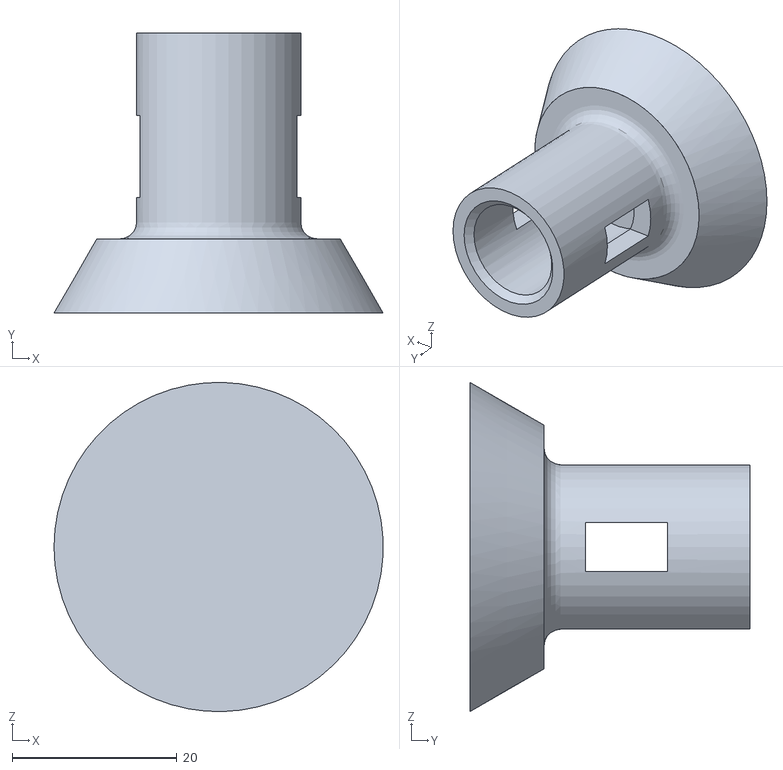
[picture p92: CAD file, 2026-05-25]
Documents/Detail Design/Arm Design/Bottom Clamp/Foot Stamp.stl
40.0 x 34.0 x 40.0
