pwbsu/Raspberry-Pi-Laparoscope/Documents/Detail Design/Arm Design/Bottom Clamp/Test1.stl

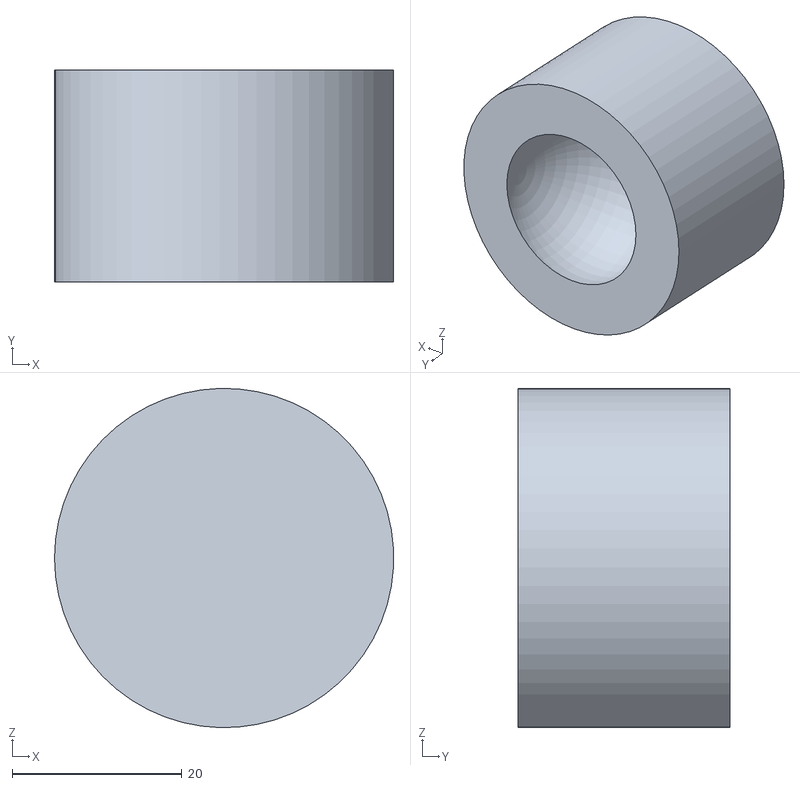
[picture p93: CAD file, 2026-05-25]
Documents/Detail Design/Arm Design/Bottom Clamp/Test1.stl
40.0 x 25.0 x 40.0
