pwbsu/Raspberry-Pi-Laparoscope/Documents/Detail Design/Arm Design/Bottom Clamp/Bottom Frame.stl

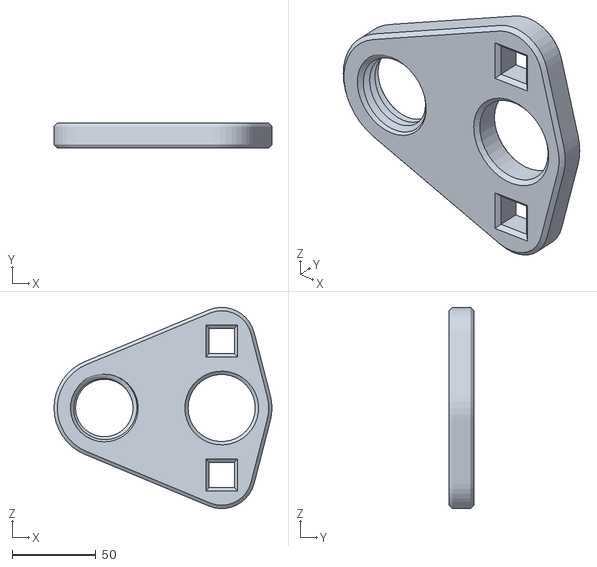
[picture p94: CAD file, 2026-05-25]
Documents/Detail Design/Arm Design/Bottom Clamp/Bottom Frame.stl
130.0 x 15.0 x 119.9
