pwbsu/Raspberry-Pi-Laparoscope/Documents/Detail Design/Arm Design/Bottom Clamp/Test Ring.stl

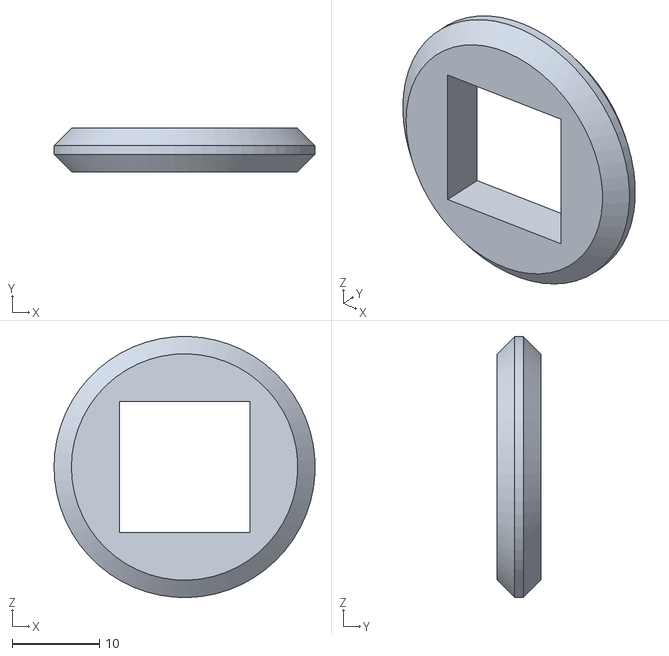
[picture p95: CAD file, 2026-05-25]
Documents/Detail Design/Arm Design/Bottom Clamp/Test Ring.stl
30.0 x 5.00 x 30.0
