pwbsu/Raspberry-Pi-Laparoscope/Documents/Detail Design/Arm Design/Bottom Clamp/Square Supports.3mf

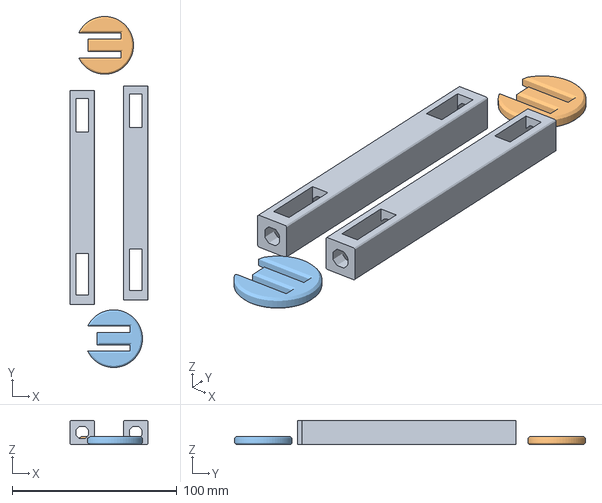
[picture p96: CAD file, 2026-05-25]
Documents/Detail Design/Arm Design/Bottom Clamp/Square Supports.3mf
47.1 x 212.9 x 14.7 mm
Square Supports.stl
Clips.stl x 2
