pwbsu/Raspberry-Pi-Laparoscope/Documents/Detail Design/Arm Design/Bottom Clamp/Small Support.stl

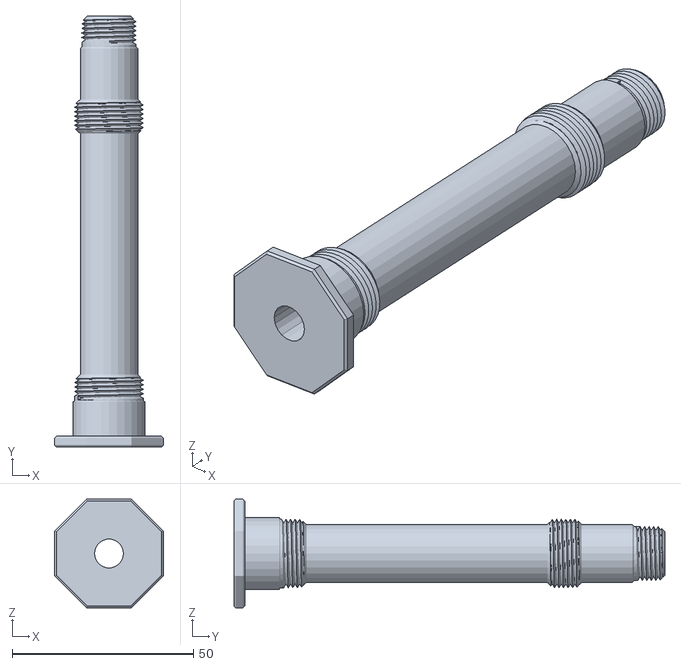
[picture p97: CAD file, 2026-05-25]
Documents/Detail Design/Arm Design/Bottom Clamp/Small Support.stl
30.0 x 119.0 x 30.0
