pwbsu/Raspberry-Pi-Laparoscope/(list of files, cad)

Other CAD files:
Documents/Concept Designs/Camera sensor.ipt
Documents/Concept Designs/Concept 1 Bended shaft design/Bended shaft concept.iam
Documents/Concept Designs/Concept 1 Bended shaft design/Bended shaft.ipt
Documents/Concept Designs/Concept 1 Bended shaft design/Camera circuit board encasing.ipt
Documents/Concept Designs/Concept 1 Bended shaft design/OldVersions/Bended shaft concept.0001.iam
Documents/Concept Designs/Concept 1 Bended shaft design/OldVersions/Bended shaft.0002.ipt
Documents/Concept Designs/Concept 1 Bended shaft design/OldVersions/Camera circuit board encasing.0002.ipt
Documents/Concept Designs/Concept 2 Tilted Camera design/Camera encasing.ipt
Documents/Concept Designs/Concept 2 Tilted Camera design/OldVersions/Camera encasing.0003.ipt
Documents/Concept Designs/Concept 2 Tilted Camera design/OldVersions/Shaft.0001.ipt
Documents/Concept Designs/Concept 2 Tilted Camera design/OldVersions/Tilted Camera Assembly.0001.iam
Documents/Concept Designs/Concept 2 Tilted Camera design/Shaft.ipt
Documents/Concept Designs/Concept 2 Tilted Camera design/Tilted Camera Assembly.iam
Documents/Concept Designs/Concept 3 1 Degree of Freedom/Camera encase.ipt
Documents/Concept Designs/Concept 3 1 Degree of Freedom/Concept 3 Assembly.iam
Documents/Concept Designs/Concept 3 1 Degree of Freedom/OldVersions/Camera Encasing.0002.ipt
Documents/Concept Designs/Concept 3 1 Degree of Freedom/OldVersions/Camera encase.0003.ipt
Documents/Concept Designs/Concept 3 1 Degree of Freedom/OldVersions/Concept 3 Assembly.0001.iam
Documents/Concept Designs/Concept 3 1 Degree of Freedom/OldVersions/Degree of freedom model.0001.iam
Documents/Concept Designs/Concept 3 1 Degree of Freedom/OldVersions/Shaft.0001.ipt
Documents/Concept Designs/Concept 3 1 Degree of Freedom/OldVersions/Steel rod.0002.ipt
Documents/Concept Designs/Concept 3 1 Degree of Freedom/Shaft.ipt
Documents/Concept Designs/Large light.ipt
Documents/Concept Designs/OldVersions/Camera sensor.0004.ipt
Documents/Concept Designs/OldVersions/Large light.0003.ipt
Documents/Concept Designs/OldVersions/Small light.0004.ipt
Documents/Concept Designs/Small light.ipt
Documents/Detail Design/3D Printing/Handle_Front_End.ipt
Documents/Detail Design/3D Printing/Handle_Main_Body.ipt
Documents/Detail Design/3D Printing/Handle_Side_Covers.ipt
Documents/Detail Design/3D Printing/OldVersions/Handle_Front_End.0003.ipt
Documents/Detail Design/3D Printing/OldVersions/Handle_Main_Body.0002.ipt
Documents/Detail Design/Arm Design/Bottom Clamp/Bottom Frame.ipt
Documents/Detail Design/Arm Design/Bottom Clamp/Clips.ipt
Documents/Detail Design/Arm Design/Bottom Clamp/Clips.stl
Documents/Detail Design/Arm Design/Bottom Clamp/Foot Stamp.ipt
Documents/Detail Design/Arm Design/Bottom Clamp/Foot Swivel.ipt
Documents/Detail Design/Arm Design/Bottom Clamp/Large Screw.ipt
Documents/Detail Design/Arm Design/Bottom Clamp/Large Screw.stl
Documents/Detail Design/Arm Design/Bottom Clamp/OldVersions/Bottom Frame.0006.ipt
Documents/Detail Design/Arm Design/Bottom Clamp/OldVersions/Cube_Stand.0001.ipt
Documents/Detail Design/Arm Design/Bottom Clamp/OldVersions/Large Screw.0001.ipt
Documents/Detail Design/Arm Design/Bottom Clamp/OldVersions/Pin.0002.ipt
Documents/Detail Design/Arm Design/Bottom Clamp/OldVersions/Power Screw.0003.ipt
Documents/Detail Design/Arm Design/Bottom Clamp/OldVersions/Small Screw.0003.ipt
Documents/Detail Design/Arm Design/Bottom Clamp/OldVersions/Small Support.0005.ipt
Documents/Detail Design/Arm Design/Bottom Clamp/OldVersions/Square Supports.0001.ipt
Documents/Detail Design/Arm Design/Bottom Clamp/OldVersions/Test Square.0001.ipt
Documents/Detail Design/Arm Design/Bottom Clamp/OldVersions/Test2.0001.ipt
Documents/Detail Design/Arm Design/Bottom Clamp/OldVersions/Top Frame.0002.ipt
Documents/Detail Design/Arm Design/Bottom Clamp/Pin.ipt
Documents/Detail Design/Arm Design/Bottom Clamp/Power Screw.3mf
Documents/Detail Design/Arm Design/Bottom Clamp/Power Screw.ipt
Documents/Detail Design/Arm Design/Bottom Clamp/Power Screw.stl
Documents/Detail Design/Arm Design/Bottom Clamp/Small Screw.ipt
Documents/Detail Design/Arm Design/Bottom Clamp/Small Screw.stl
Documents/Detail Design/Arm Design/Bottom Clamp/Small Support.ipt
Documents/Detail Design/Arm Design/Bottom Clamp/Spacer.ipt
Documents/Detail Design/Arm Design/Bottom Clamp/Square Supports.ipt
Documents/Detail Design/Arm Design/Bottom Clamp/Square Supports.stl
Documents/Detail Design/Arm Design/Bottom Clamp/Test Ring.ipt
Documents/Detail Design/Arm Design/Bottom Clamp/Test Square.ipt
Documents/Detail Design/Arm Design/Bottom Clamp/Test1.ipt
Documents/Detail Design/Arm Design/Bottom Clamp/Test2.ipt
Documents/Detail Design/Arm Design/Bottom Clamp/Top Frame.ipt
Documents/Detail Design/Arm Design/Fulle Assembly.iam
Documents/Detail Design/Arm Design/OldVersions/Full Assembly.0004.iam
Documents/Detail Design/Building Parts/Belt Holder.ipt
Documents/Detail Design/Building Parts/Camera Holder 1.ipt
Documents/Detail Design/Building Parts/Camera Mold.iam
Documents/Detail Design/Building Parts/Front Bracket.ipt
Documents/Detail Design/Building Parts/OldVersions/Camera Holder 1.0002.ipt
Documents/Detail Design/Building Parts/OldVersions/Front Bracket.0003.ipt
Documents/Detail Design/Building Parts/OldVersions/Top Bracket.0002.ipt
Documents/Detail Design/Building Parts/Ring.ipt
Documents/Detail Design/Building Parts/Top Bracket.ipt
Documents/Detail Design/Drawings/Copper_Coupler.idw
Documents/Detail Design/Drawings/Copper_Coupler_Tip.idw
Documents/Detail Design/Drawings/FULL_ASSEMBLY.idw
Documents/Detail Design/Drawings/Handle_Assembly.idw
Documents/Detail Design/Drawings/Handle_Front_Cover.idw
Documents/Detail Design/Drawings/Handle_Main_Cover.idw
Documents/Detail Design/Drawings/Handle_Top_Cover.idw
Documents/Detail Design/Drawings/Heat_Sinks_Modified.idw
Documents/Detail Design/Drawings/Main_Body_Assembly.idw
Documents/Detail Design/Drawings/OldVersions/Copper_Coupler.0003.idw
Documents/Detail Design/Drawings/OldVersions/Copper_Coupler_Tip.0005.idw
Documents/Detail Design/Drawings/OldVersions/FULL_ASSEMBLY.0002.idw
Documents/Detail Design/Drawings/OldVersions/Handle_Assembly.0005.idw
Documents/Detail Design/Drawings/OldVersions/Handle_Front_Cover.0005.idw
Documents/Detail Design/Drawings/OldVersions/Handle_Main_Cover.0005.idw
Documents/Detail Design/Drawings/OldVersions/Handle_Top_Cover.0006.idw
Documents/Detail Design/Drawings/OldVersions/Heat_Sinks_Modified.0005.idw
Documents/Detail Design/Drawings/OldVersions/Main_Body_Assembly.0003.idw
Documents/Detail Design/Drawings/OldVersions/Stainless_Steel_Pipe.0002.idw
Documents/Detail Design/Drawings/OldVersions/Standard Version.0006.idw
Documents/Detail Design/Drawings/OldVersions/Stellenbosch A3 English.0004.idw
Documents/Detail Design/Drawings/Stainless_Steel_Pipe.idw
Documents/Detail Design/Drawings/Standard Version.idw
Documents/Detail Design/Full_Assembly.iam
Documents/Detail Design/Full_Assembly.idw
Documents/Detail Design/Handle Design/Front_Cover.ipt
Documents/Detail Design/Handle Design/Handle_Assembly.iam
Documents/Detail Design/Handle Design/Heat_Inserts.ipt
Documents/Detail Design/Handle Design/Main_Cover.ipt
Documents/Detail Design/Handle Design/OldVersions/Front_Cover.0004.ipt
Documents/Detail Design/Handle Design/OldVersions/Handle_Assembly.0008.iam
Documents/Detail Design/Handle Design/OldVersions/Heat_Inserts.0001.ipt
Documents/Detail Design/Handle Design/OldVersions/Main_Cover.0008.ipt
Documents/Detail Design/Handle Design/OldVersions/Top Covers.0002.ipt
Documents/Detail Design/Handle Design/OldVersions/Top_Covers.0004.ipt
Documents/Detail Design/Handle Design/Top_Covers.ipt
Documents/Detail Design/Main Body Design/Copper_Coupler.ipt
Documents/Detail Design/Main Body Design/Heat Pipe 100 mm.ipt
Documents/Detail Design/Main Body Design/Heat Pipe 250 mm.ipt
Documents/Detail Design/Main Body Design/Heat Sink Holed drilled.ipt
Documents/Detail Design/Main Body Design/Main_Body_Assembly.iam
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
