pwbsu/Raspberry-Pi-Laparoscope/Documents/Testing Procedures/Raw Values.xlsx

Sheet: Temperature Probe Calibration
 | Measurement 1 |  |  | Measurement 2
Input Ref | Input Resistance | Measured Temperature | Calculated Temperature | Input Resistance | Measured Temperature | Calculated Temperature
80 | 130.765 | 78.8 | 79.54762273 |  |  | -243.7648049
70 | 127.035 | 69.2 | 69.79645465 |  |  | -243.7648049
60 | 123.222 | 59.4 | 59.86040442 |  |  | -243.7648049
50 | 119.42 | 49.7 | 49.98533226 |  |  | -243.7648049
40 | 115.585 | 39.9 | 40.05723651 |  |  | -243.7648049
30 | 111.722 | 30.1 | 30.08984419 |  |  | -243.7648049
20 | 107.863 | 20.4 | 20.16603194 |  |  | -243.7648049
10 | 103.952 | 10.6 | 10.14241326 |  |  | -243.7648049
0 | 100.084 | 0.9 | 0.262583389 |  |  | -243.7648049
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
