pwbsu/Raspberry-Pi-Laparoscope/Documents/Detail Design/Full_Assembly.pdf

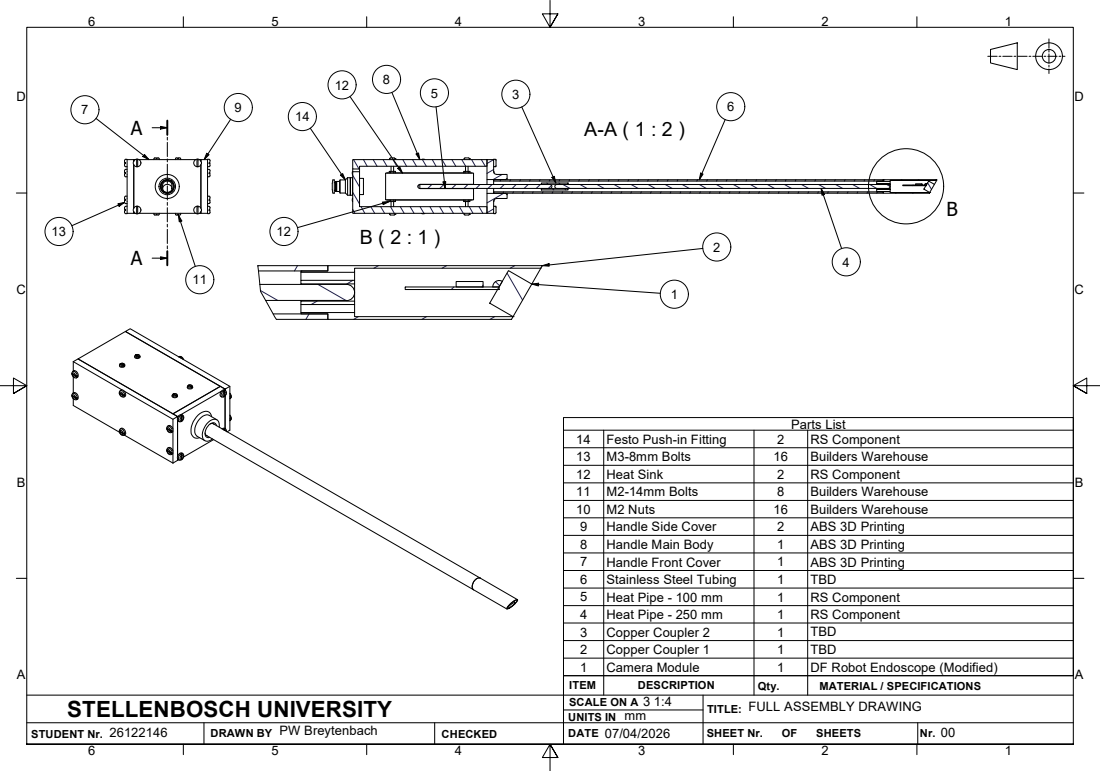
[picture p98: page 1]
Parts List; STUDENT Nr.; DRAWN BY; CHECKED; UNITS IN; SHEET Nr.; SHEETS; PW Breytenbach

14 | Festo Push-in Fitting | 2 | RS Component
13 | M3-8mm Bolts | 16 | Builders Warehouse
12 | Heat Sink | 2 | RS Component
11 | M2-14mm Bolts | 8 | Builders Warehouse
10 | M2 Nuts | 16 | Builders Warehouse
9 | Handle Side Cover | 2 | ABS 3D Printing
8 | Handle Main Body | 1 | ABS 3D Printing
7 | Handle Front Cover | 1 | ABS 3D Printing
6 | Stainless Steel Tubing | 1 | TBD
5 | Heat Pipe - 100 mm | 1 | RS Component
4 | Heat Pipe - 250 mm | 1 | RS Component
3 | Copper Coupler 2 | 1 | TBD
2 | Copper Coupler 1 | 1 | TBD
1 | Camera Module | 1 | DF Robot Endoscope (Modified)
ITEM | DESCRIPTION | Qty. | MATERIAL / SPECIFICATIONS

STELLENBOSCH UNIVERSITY | 3 1:4 SCALE ON A | FULL ASSEMBLY DRAWING TITLE:
