pwbsu/Raspberry-Pi-Laparoscope/Documents/Detail Design/Drawings/Copper_Coupler.pdf

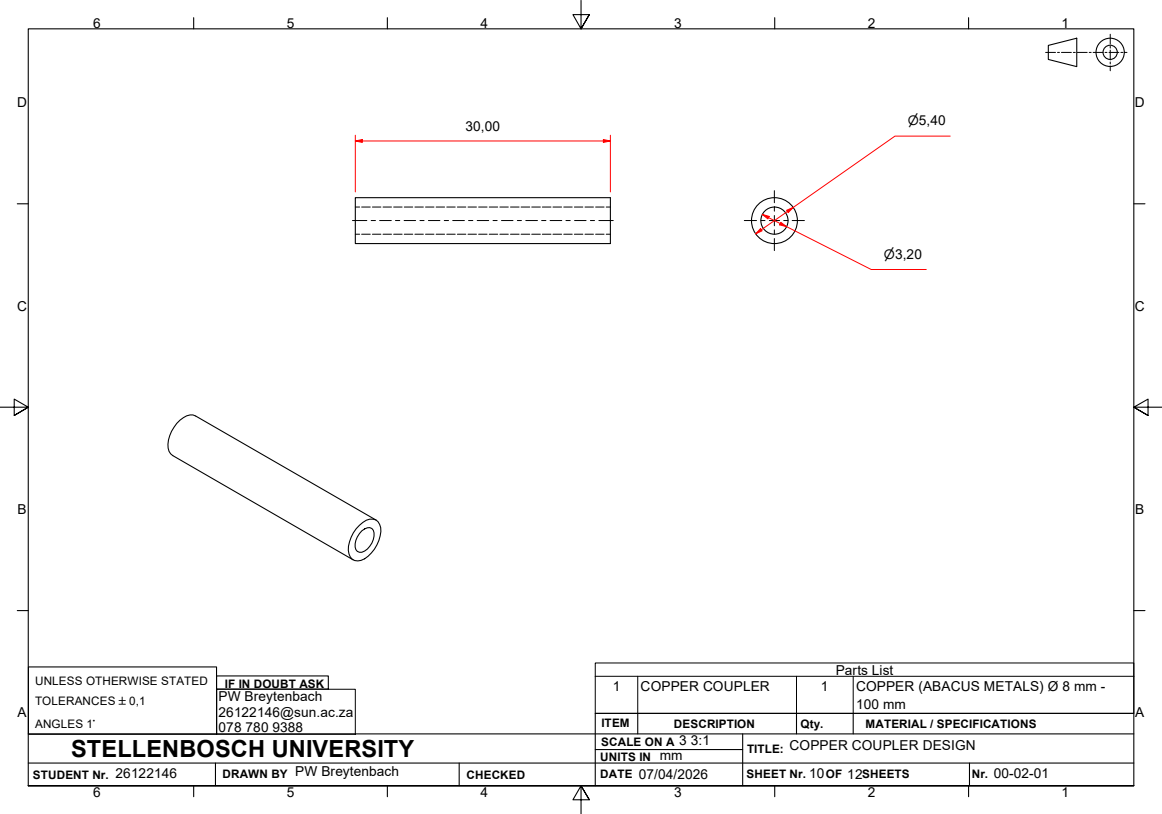
[picture p99: page 1]
COPPER COUPLER; STUDENT Nr.; DRAWN BY; CHECKED; UNITS IN; SHEET Nr.; SHEETS; PW Breytenbach

Parts List
COPPER (ABACUS METALS) Ø 8 mm -

UNLESS OTHERWISE STATED
TOLERANCES `0,1
ANGLES 1~

IF IN DOUBT ASK
PW Breytenbach
26122146@sun.ac.za

ITEM | DESCRIPTION | Qty. | MATERIAL / SPECIFICATIONS

STELLENBOSCH UNIVERSITY | 3 3:1 SCALE ON A | COPPER COUPLER DESIGN TITLE:
