pwbsu/Raspberry-Pi-Laparoscope/Documents/Detail Design/Drawings/FULL_ASSEMBLY_1.pdf

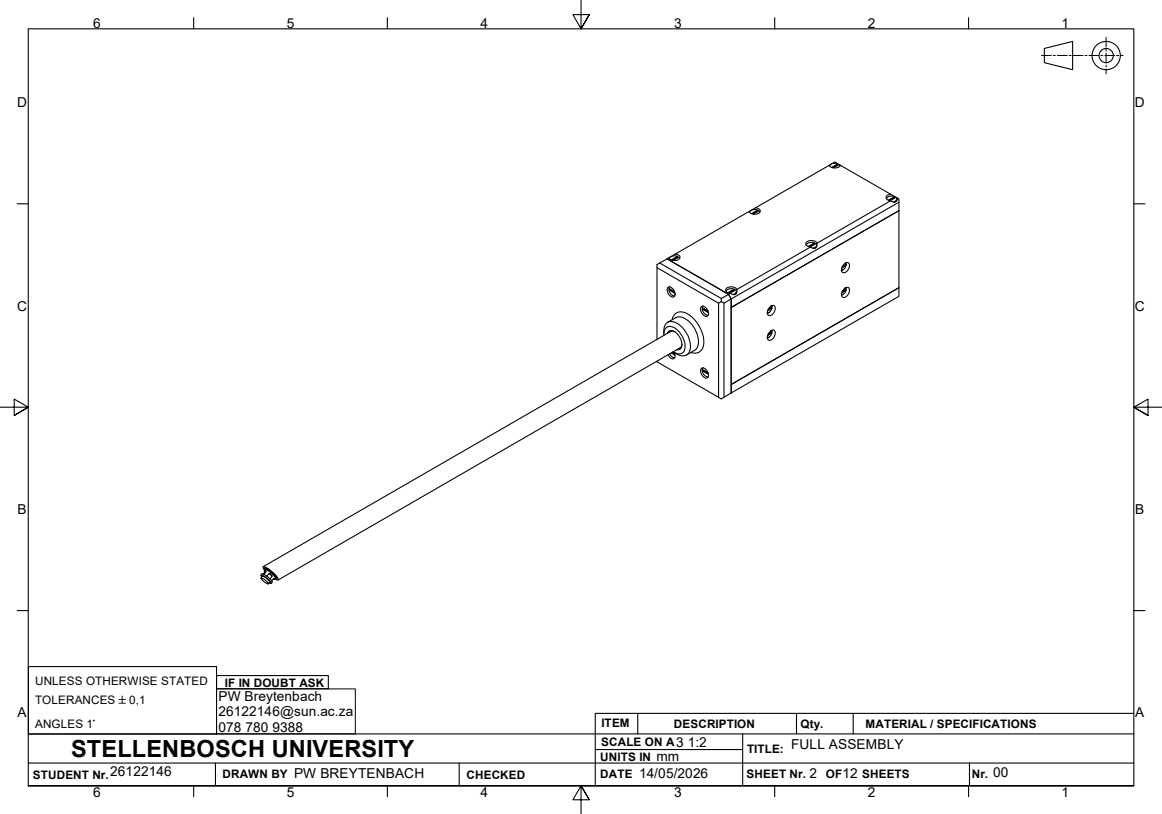
[picture p100: page 1]
STUDENT Nr.; DRAWN BY; CHECKED; UNITS IN; SHEET Nr.; SHEETS; PW BREYTENBACH; UNLESS OTHERWISE STATED; IF IN DOUBT ASK; TOLERANCES `0,1; ANGLES 1~

PW Breytenbach
26122146@sun.ac.za

ITEM | DESCRIPTION | Qty. | MATERIAL / SPECIFICATIONS

STELLENBOSCH UNIVERSITY | SCALE ON A 3 1:2 | FULL ASSEMBLY TITLE:
