pwbsu/Raspberry-Pi-Laparoscope/Documents/Detail Design/Drawings/Handle_Assembly.pdf

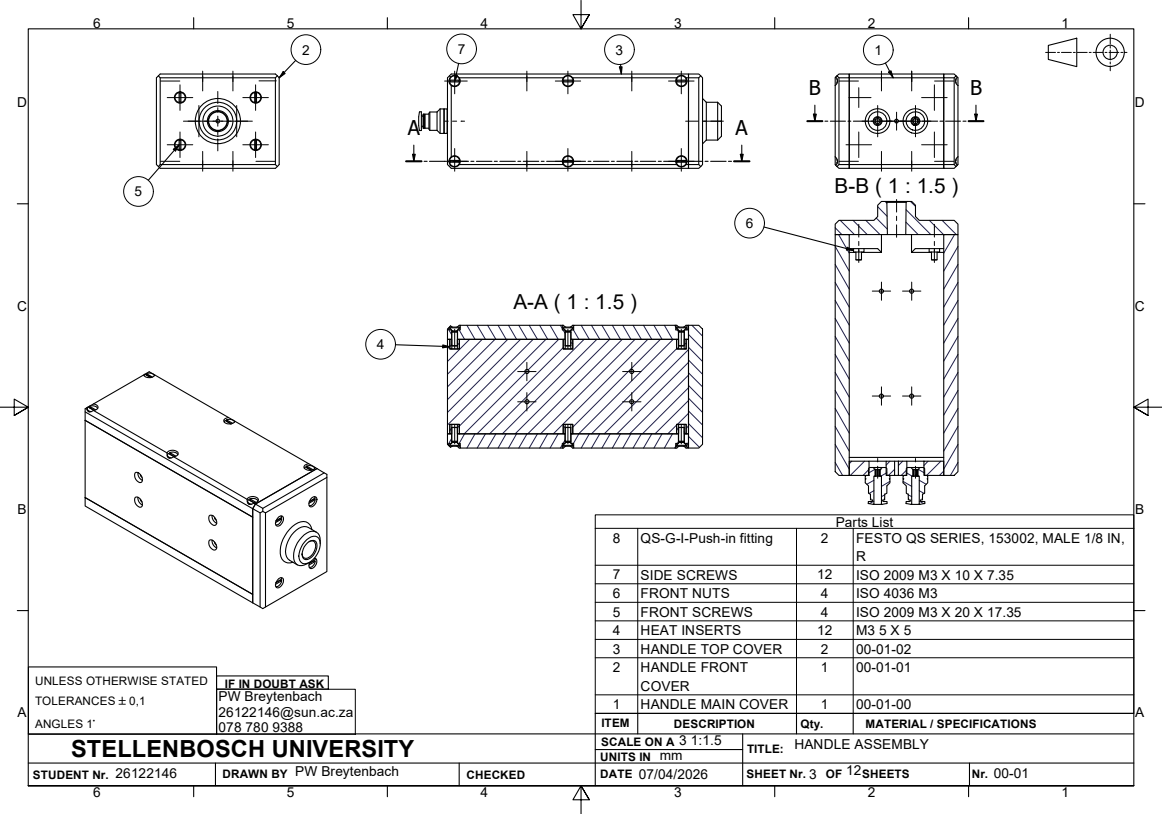
[picture p101: page 1]
Parts List; STUDENT Nr.; DRAWN BY; CHECKED; UNITS IN; SHEET Nr.; SHEETS; PW Breytenbach

8 | QS-G-I-Push-in fitting | 2 | FESTO QS SERIES, 153002, MALE 1/8 IN, R

7 | SIDE SCREWS | 12 | ISO 2009 M3 X 10 X 7.35
6 | FRONT NUTS | 4 | ISO 4036 M3
5 | FRONT SCREWS | 4 | ISO 2009 M3 X 20 X 17.35
4 | HEAT INSERTS | 12 | M3 5 X 5
3 | HANDLE TOP COVER | 2 | 00-01-02
2 | HANDLE FRONT COVER | 1 | 00-01-01

UNLESS OTHERWISE STATED
TOLERANCES `0,1
ANGLES 1~

IF IN DOUBT ASK
PW Breytenbach
26122146@sun.ac.za

1 | HANDLE MAIN COVER | 1 | 00-01-00
ITEM | DESCRIPTION | Qty. | MATERIAL / SPECIFICATIONS

STELLENBOSCH UNIVERSITY | 3 1:1.5 SCALE ON A | HANDLE ASSEMBLY TITLE:
