pwbsu/Raspberry-Pi-Laparoscope/Documents/Detail Design/Drawings/Handle_Front_Cover.pdf

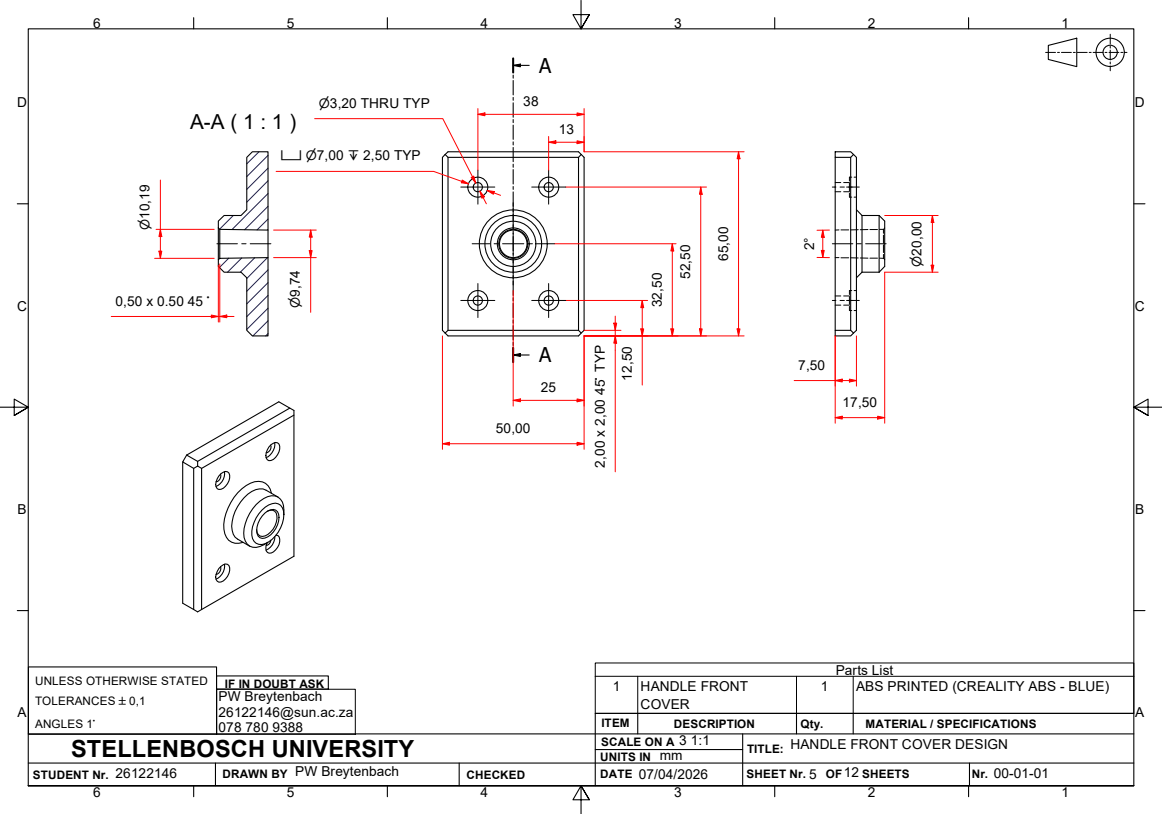
[picture p102: page 1]
Parts List; HANDLE FRONT; ABS PRINTED (CREALITY ABS - BLUE); STUDENT Nr.; DRAWN BY; CHECKED; UNITS IN; SHEET Nr.; SHEETS; PW Breytenbach; ⌀3,20 THRU TYP; ⌴ ⌀7,00 ↧ 2,50 TYP

UNLESS OTHERWISE STATED
TOLERANCES `0,1
ANGLES 1~

IF IN DOUBT ASK
PW Breytenbach
26122146@sun.ac.za

ITEM | DESCRIPTION | Qty. | MATERIAL / SPECIFICATIONS

STELLENBOSCH UNIVERSITY | 3 1:1 SCALE ON A | HANDLE FRONT COVER DESIGN TITLE:
