pwbsu/Raspberry-Pi-Laparoscope/Documents/Detail Design/Drawings/Handle_Main_Cover.pdf

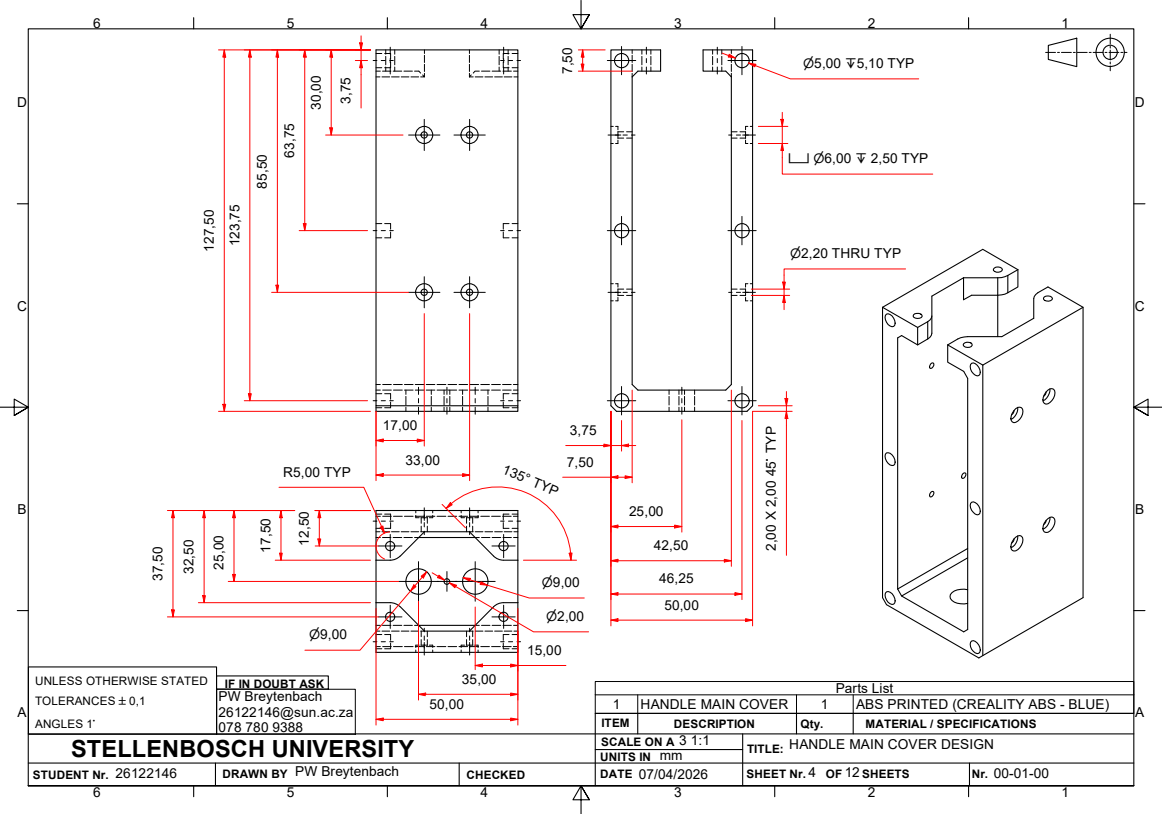
[picture p103: page 1]
Parts List; HANDLE MAIN COVER; ABS PRINTED (CREALITY ABS - BLUE); STUDENT Nr.; DRAWN BY; CHECKED; UNITS IN; SHEET Nr.; SHEETS; PW Breytenbach; ⌀5,00 ↧5,10 TYP; ⌴ ⌀6,00 ↧ 2,50 TYP; ⌀2,20 THRU TYP; R5,00 TYP; 135° TYP

UNLESS OTHERWISE STATED
TOLERANCES `0,1
ANGLES 1~

IF IN DOUBT ASK
PW Breytenbach
26122146@sun.ac.za

ITEM | DESCRIPTION | Qty. | MATERIAL / SPECIFICATIONS

STELLENBOSCH UNIVERSITY | 3 1:1 SCALE ON A | HANDLE MAIN COVER DESIGN TITLE:
