pwbsu/Raspberry-Pi-Laparoscope/Documents/Detail Design/Drawings/Handle_Top_Cover.pdf

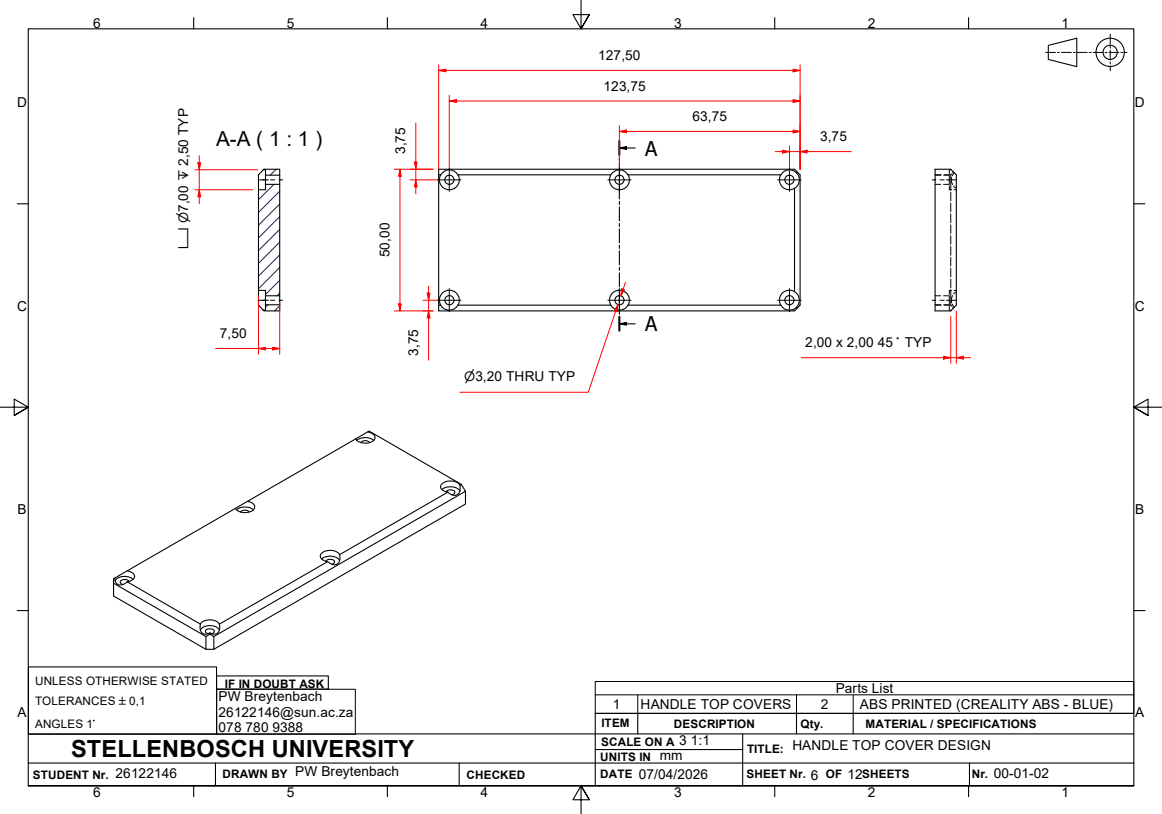
[picture p104: page 1]
Parts List; STUDENT Nr.; DRAWN BY; CHECKED; UNITS IN; SHEET Nr.; SHEETS; PW Breytenbach; 2,00 x 2,00 45 ~ TYP; ⌀3,20 THRU TYP

UNLESS OTHERWISE STATED
TOLERANCES `0,1
ANGLES 1~

IF IN DOUBT ASK
PW Breytenbach
26122146@sun.ac.za

1 | HANDLE TOP COVERS | 2 | ABS PRINTED (CREALITY ABS - BLUE)
ITEM | DESCRIPTION | Qty. | MATERIAL / SPECIFICATIONS

STELLENBOSCH UNIVERSITY | 3 1:1 SCALE ON A | HANDLE TOP COVER DESIGN TITLE:
