pwbsu/Raspberry-Pi-Laparoscope/Documents/Detail Design/Drawings/Heat_Sinks_Modified.pdf

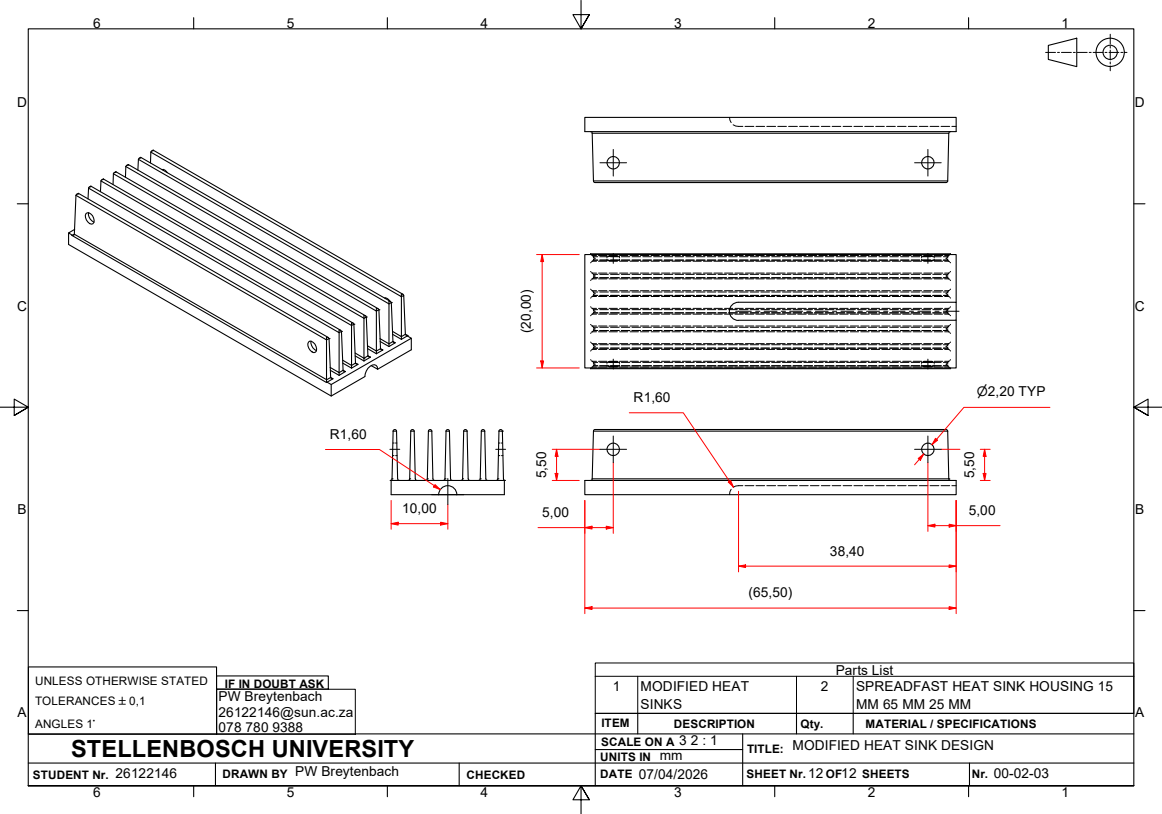
[picture p105: page 1]
MODIFIED HEAT; STUDENT Nr.; DRAWN BY; CHECKED; UNITS IN; SHEET Nr.; SHEETS; PW Breytenbach; ⌀2,20 TYP

Parts List
SPREADFAST HEAT SINK HOUSING 15

UNLESS OTHERWISE STATED
TOLERANCES `0,1
ANGLES 1~

IF IN DOUBT ASK
PW Breytenbach
26122146@sun.ac.za

ITEM | DESCRIPTION | Qty. | MATERIAL / SPECIFICATIONS

STELLENBOSCH UNIVERSITY | 3 2 : 1 SCALE ON A | MODIFIED HEAT SINK DESIGN TITLE:
