pwbsu/Raspberry-Pi-Laparoscope/Documents/Detail Design/Drawings/Stainless_Steel_Pipe.pdf

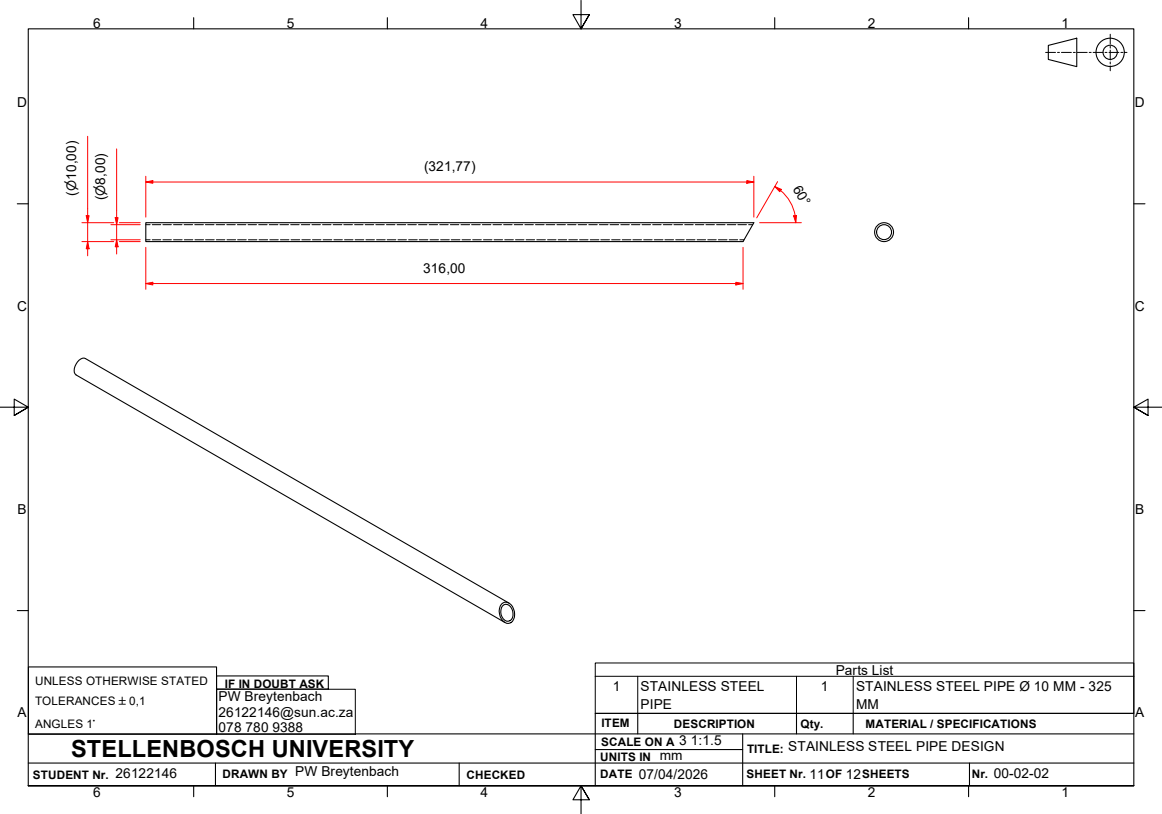
[picture p106: page 1]
STAINLESS STEEL; STUDENT Nr.; DRAWN BY; CHECKED; UNITS IN; SHEET Nr.; SHEETS; PW Breytenbach

Parts List
STAINLESS STEEL PIPE Ø 10 MM - 325

UNLESS OTHERWISE STATED
TOLERANCES `0,1
ANGLES 1~

IF IN DOUBT ASK
PW Breytenbach
26122146@sun.ac.za

ITEM | DESCRIPTION | Qty. | MATERIAL / SPECIFICATIONS

STELLENBOSCH UNIVERSITY | 3 1:1.5 SCALE ON A | STAINLESS STEEL PIPE DESIGN TITLE:
