pwbsu/Raspberry-Pi-Laparoscope/(commit log)

2026-03-03 First Commit: 03-03-2026
    [Choices.xlsx, General Attributes.xlsx, Planned activities.xlsx]
2026-03-04 04/03/2026 commit: Edit Literaure Document. Created 2 new Documents. Progress Report and Literature Review Report
    [Planned activities.xlsx]
2026-05-25 25/05/2026 commit
    [186106 QS-G1_8-4-I.0001.ipt, 186106 QS-G1_8-4-I.ipt, Available Products Specifications.xlsx, Belt Holder.ipt, Belt Holder.stl, Bended shaft concept.0001.iam, Bended shaft concept.iam, Bended shaft.0002.ipt]
